Marek128b/HAM-Radio-transceiver-DA/filters/20m BP Filter/README.md

# 20m (14MHz - 14.35MHz) BP Filter 

** table of content **
- [20m (14MHz - 14.35MHz) BP Filter](#20m-14mhz---1435mhz-bp-filter)
  - [Description](#description)
  - [Circuit](#circuit)
  - [How it looks like in Real life](#how-it-looks-like-in-real-life)

## Description 
Bandpass filters are used to effectively reduce strong signals outside the operating band. This reduces noise and in-band noise, in a receiver there is a much lower risk of producing unwanted signals in the mixer. This gives better overall reception. <br>
On the transmit side, spurious emission signals are suppressed as well, reducing interference with the neighbouring stations. 

[comment]: <https://www.wimo.com/en/12410-20> (copied text from here)

## Circuit
The Circuit was designed with the online 
[Filter Tool](https://markimicrowave.com/technical-resources/tools/lc-filter-design-tool/)
to have a lower Frequency of 13MHz and a rather high upper cutoff frequency of 17MHz. 
The Air coils where calculated using the [Coil 32 online Tool](https://coil32.net/online-calculators/one-layer-coil-calculator.html). The coils where wound by hand using Wrapping wire around a 3D-Printed plastic core with respected diameters and lengths. <br>
The 3D-designs are found in the `20m BP Filter/hardware` folder.

<br>
20m 3rd Order Chebyshev Filter 

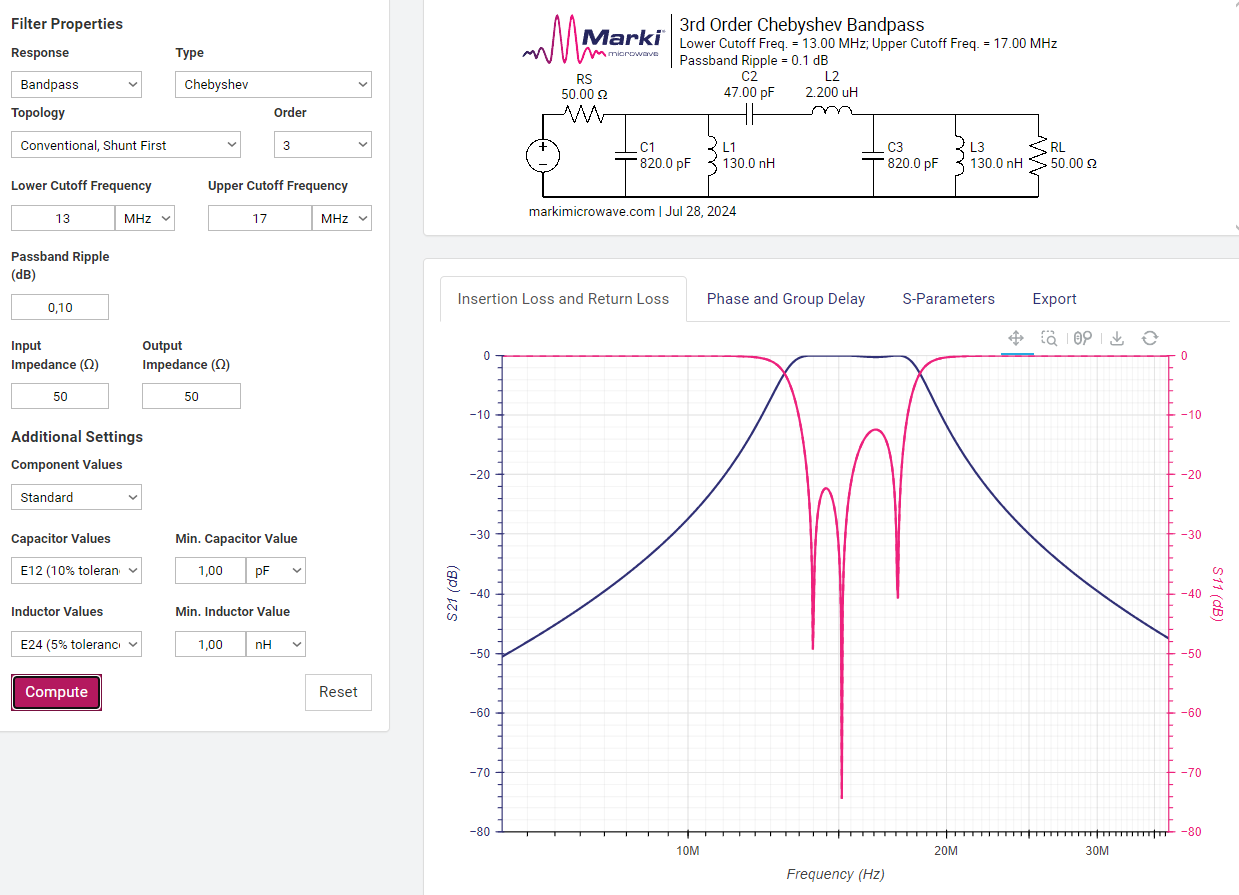
[picture p2: filters/20m BP Filter/img/Marki Filter 20m BO.PNG]


<br>
Simulated using LT-Spice with theoretical practical values:



<br>
Measured with the NanoVNA:

config in NanoVNA Saver v0.6.4:



S21 graph:



markers:



## How it looks like in Real life
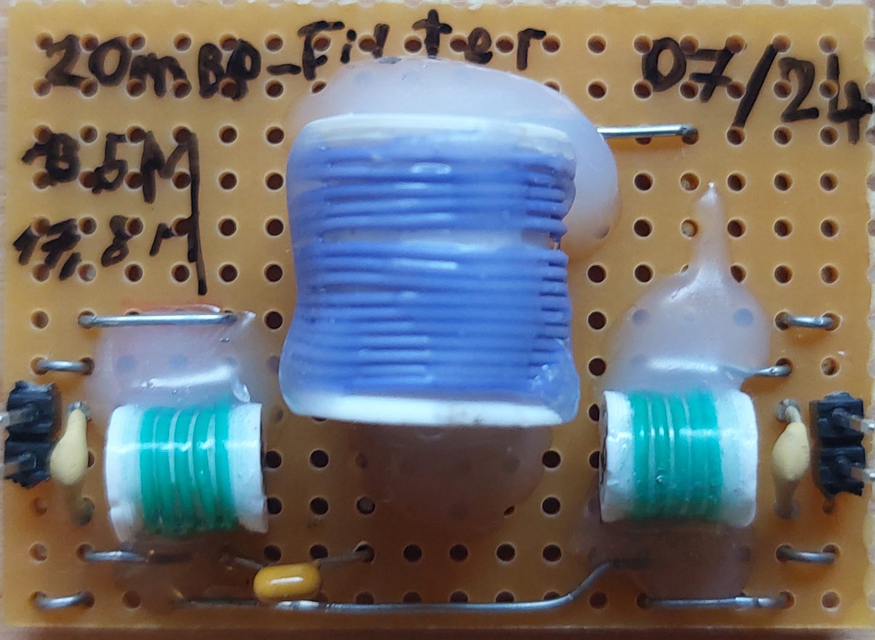
[picture p3: filters/20m BP Filter/img/WhatsApp Image 2024-07-28 at 16.52.38.jpeg]
