Marek128b/HAM-Radio-transceiver-DA/webpage/DocPage/content/1.Overview/_index.md

+++
archetype = "chapter"
title = "Overview"
weight = 1
+++

In this chapter you will find a quick overview about this documentation page and the ham radio project.

```mermaid {zoom="false"}
pie title Money for the project
  "Si5351" : 7
  "3.5 inch TFT LCD Module" : 17
  "ESP32-S3-DevKitC-1 Board" : 14
  "Hammond case 1455U1602BK" : 38
```
