Marek128b/HAM-Radio-transceiver-DA/webpage/DocPage/content/6.Schematics/_index.md

+++
archetype = "chapter"
title = "Schematics"
weight = 6
+++

This is a new chapter.
