Marek128b/HAM-Radio-transceiver-DA/webpage/DocPage/content/2.Filters/_index.md

+++
archetype = "chapter"
title = "Filters"
weight = 2
+++

This is a new chapter.
