Marek128b/HAM-Radio-transceiver-DA/webpage/DocPage/content/4.Power_Amplifier/_index.md

+++
archetype = "chapter"
title = "Power_Amplifier"
weight = 4
+++

This is a new chapter.
