Marek128b/HAM-Radio-transceiver-DA/webpage/DocPage/content/_index.md

### Image of the FunkY

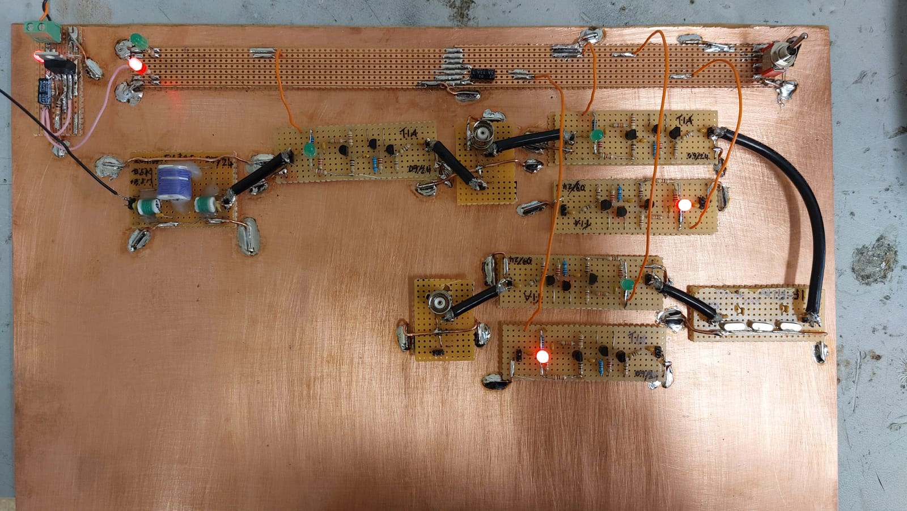
[picture p13: webpage/DocPage/content/WhatsApp Image 2024-10-16 at 08.23.57.jpeg]
something went wrong


### What this is about
This Project is an analog amateur radio for the 20m (14MHz) band. The aim of this project is to get beginners and non beginners into building their own amateur radio stations. This project webpage is a detailed documentation on how every component works and how to measure them and put the ham radio transceiver together.
