Marek128b/HAM-Radio-transceiver-DA/doc/concept presentation start.pptx

## Amateur funk Sender und Empfänger

- Georg Marek

## Idee:

- Ein Amateurfunk sende und Empfangs Einrichtung
- 10m bis 160m
- LSB, USB, CW

Georg Marek

## Blockschaltbild:

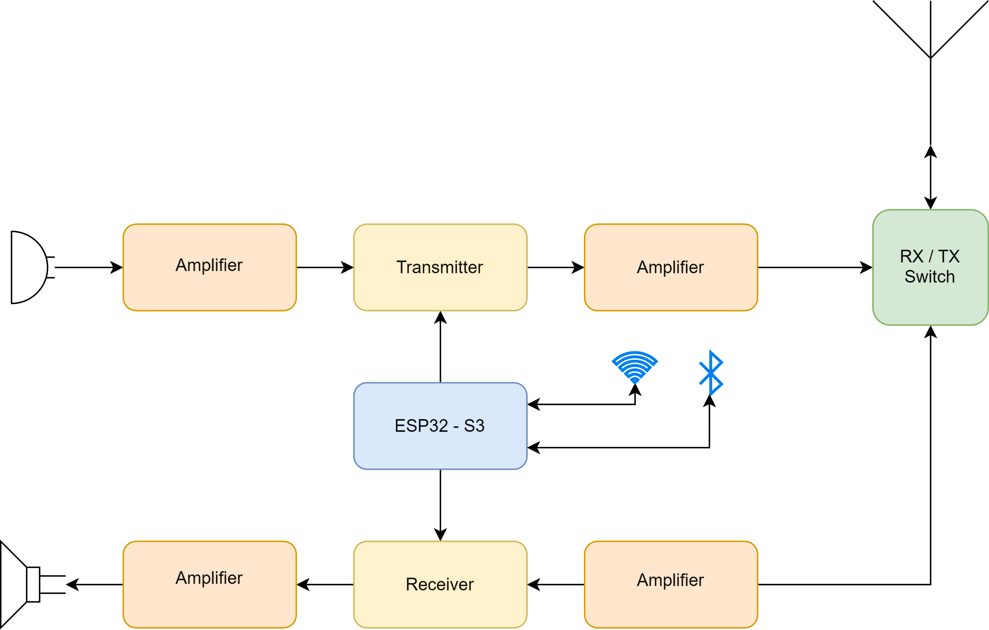
[picture p14: figure]

## Arbeitsaufteilung:

Georg Marek:
Sendeelektronik
Empfangselektronik
Mikrokontroller Programmierung
Schnittstellen Programmierung

Georg Marek:
Computer Software
Schnittstellen Programmierung

4

Georg Marek
