Marek128b/HAM-Radio-transceiver-DA/doc/case/img/case v34.png

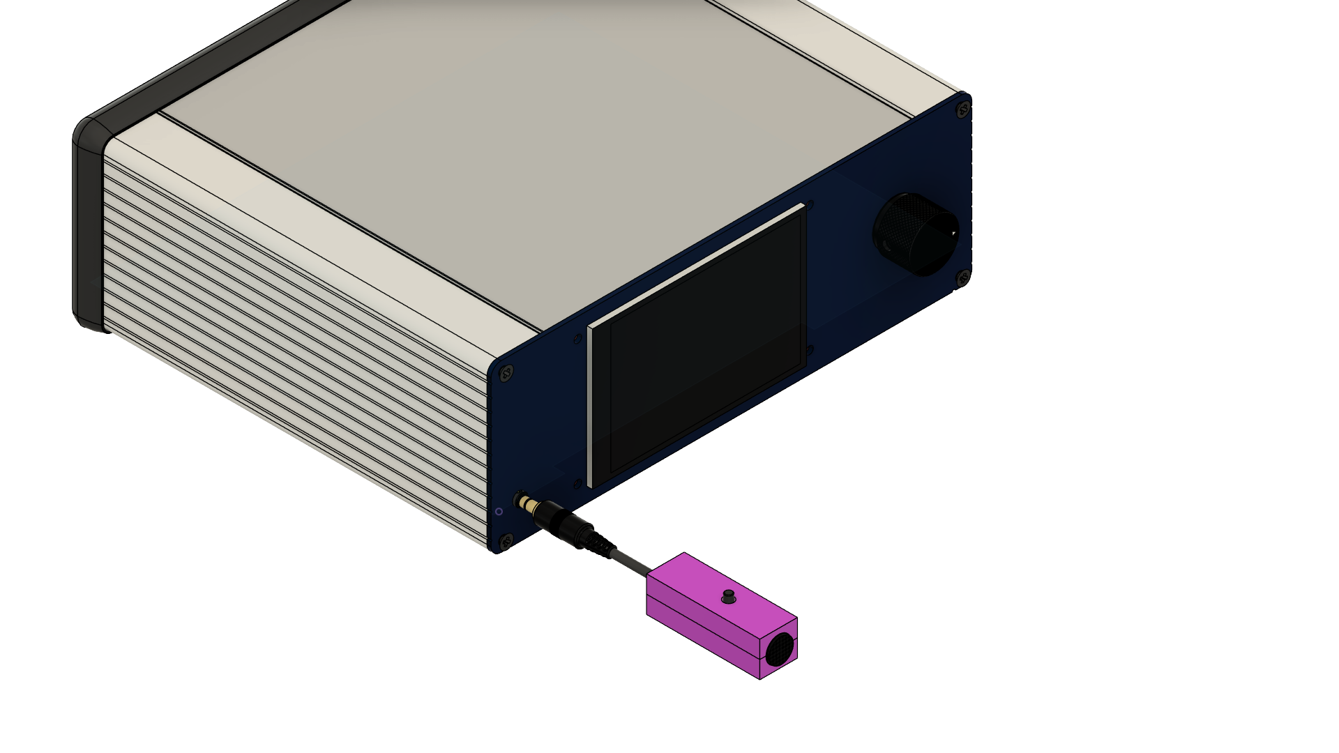
doc/case/img/case v34.png
