Marek128b/HAM-Radio-transceiver-DA/doc/case/img/case v43.png

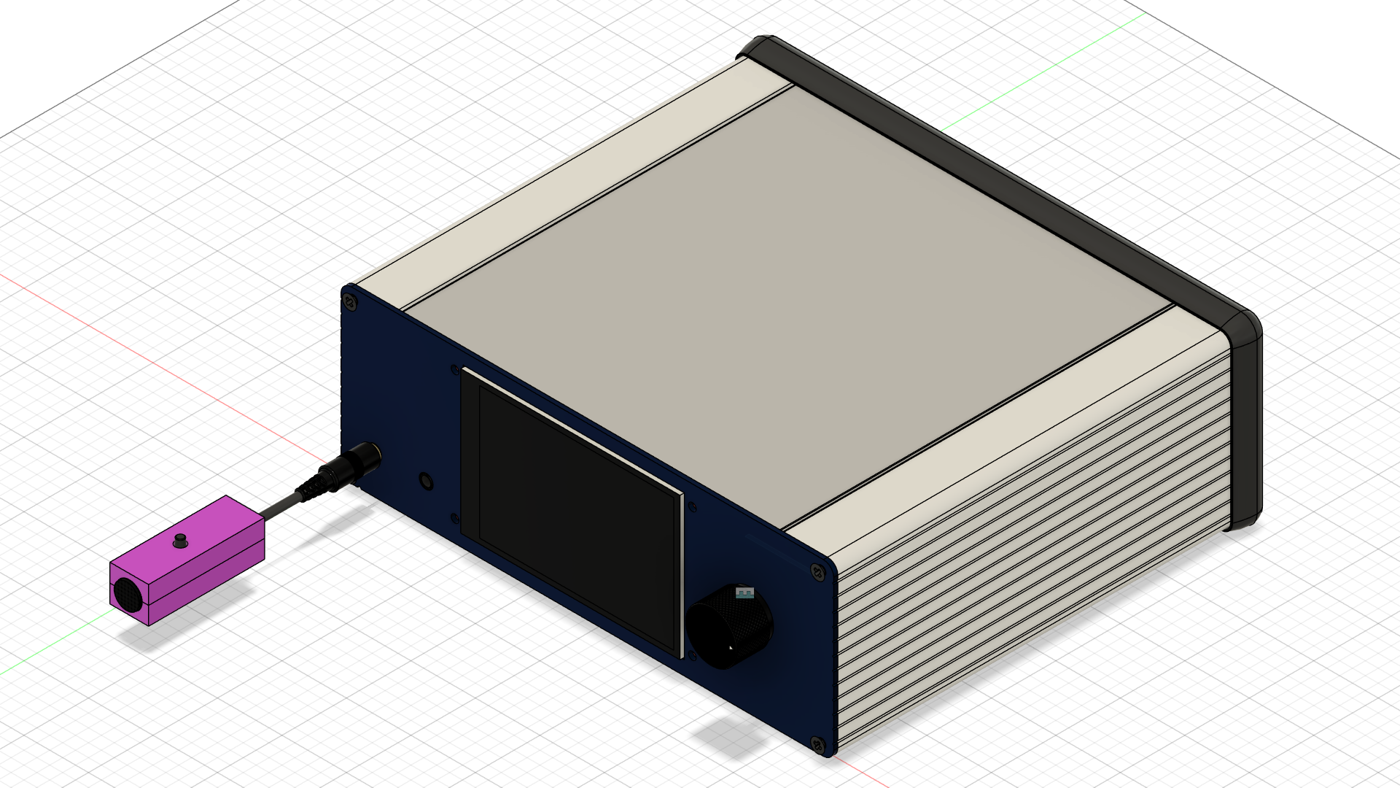
doc/case/img/case v43.png
