Marek128b/HAM-Radio-transceiver-DA/doc/img/blockdiagram.png

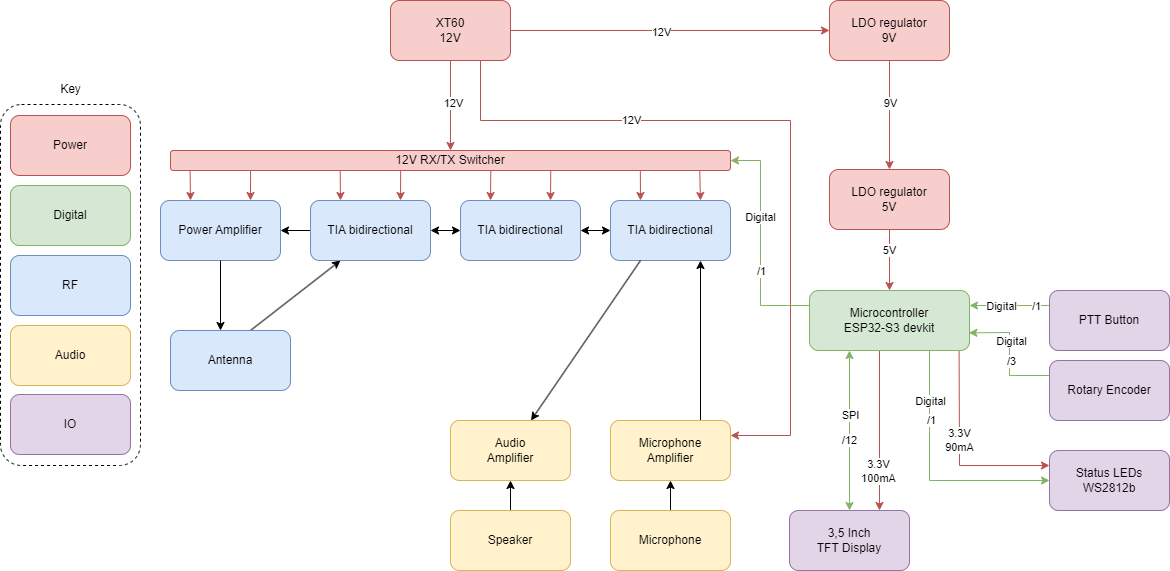
doc/img/blockdiagram.png
