Marek128b/HAM-Radio-transceiver-DA/doc/img/grundlagen-superhet-bfo.jpg

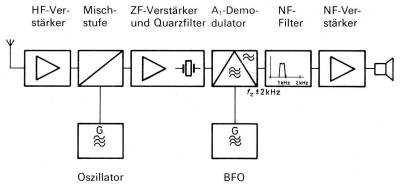
doc/img/grundlagen-superhet-bfo.jpg
