Marek128b/HAM-Radio-transceiver-DA/doc/img/grundlagen-superhet-ssb.jpg

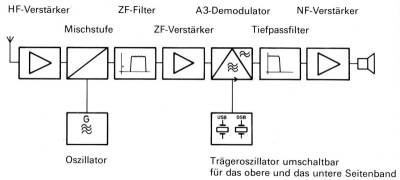
doc/img/grundlagen-superhet-ssb.jpg
