Marek128b/HAM-Radio-transceiver-DA/doc/img/Projectstructure.png

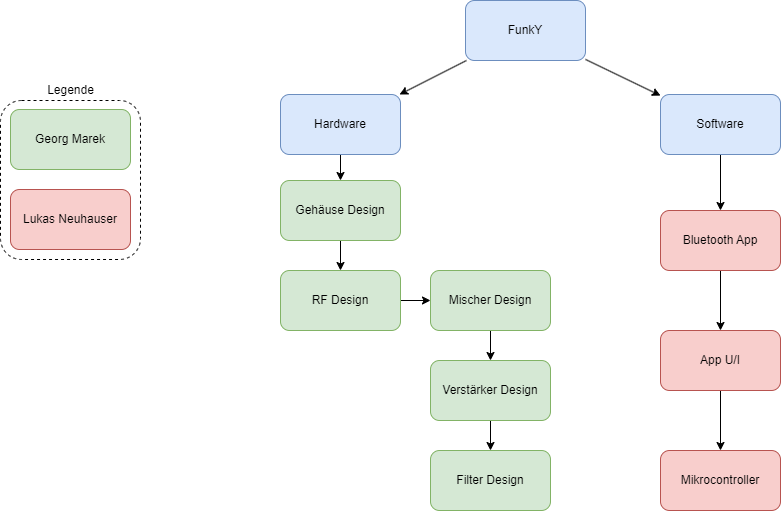
doc/img/Projectstructure.png
