Marek128b/HAM-Radio-transceiver-DA/doc/img/projectstructureplan.png

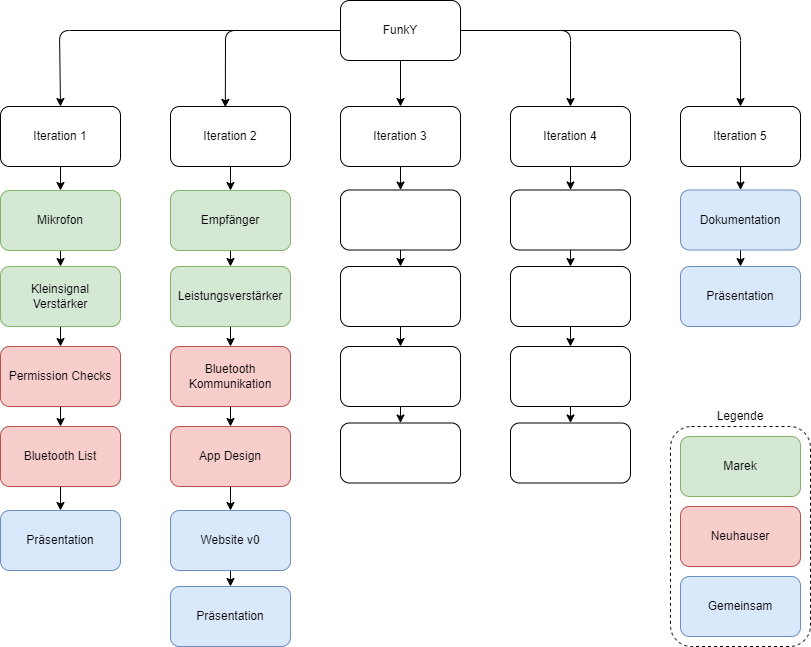
doc/img/projectstructureplan.png
