Marek128b/HAM-Radio-transceiver-DA/doc/img/recbasic2.gif

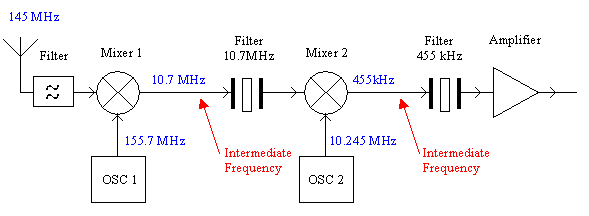
doc/img/recbasic2.gif
