Marek128b/HAM-Radio-transceiver-DA/doc/img/recbasic3.gif

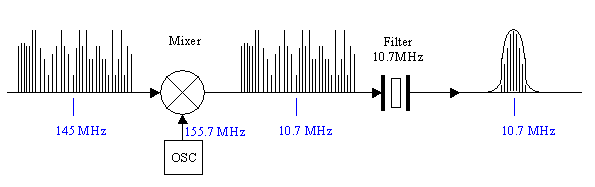
doc/img/recbasic3.gif
