Marek128b/HAM-Radio-transceiver-DA/doc/img/systemstructure.png

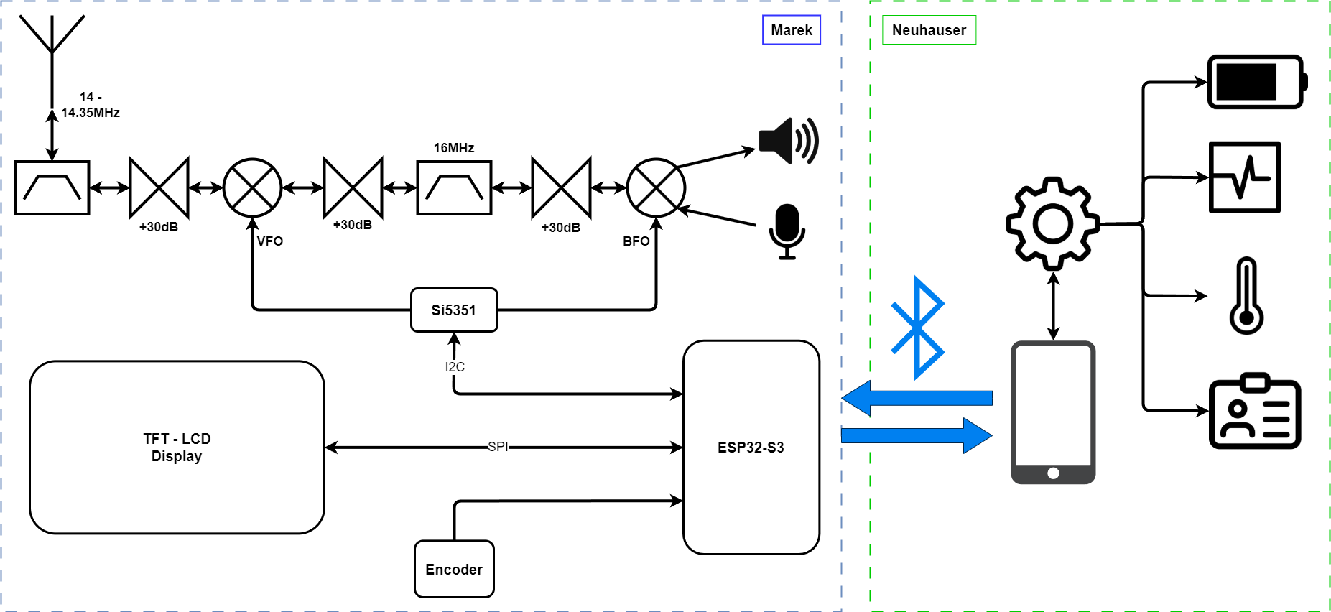
doc/img/systemstructure.png
