Marek128b/HAM-Radio-transceiver-DA/doc/img/USB-LSB.jpg

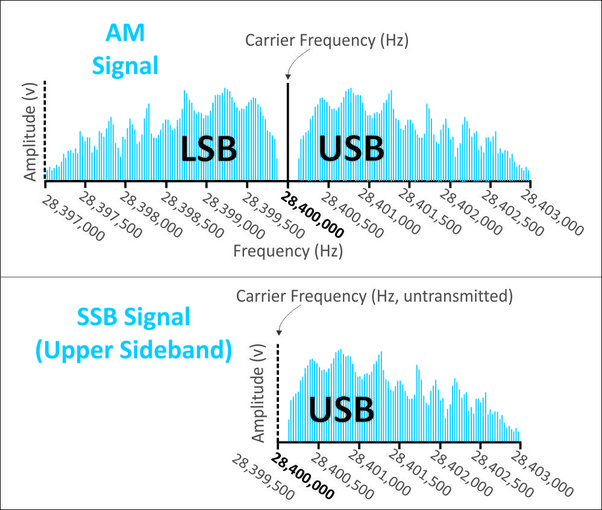
doc/img/USB-LSB.jpg
