Marek128b/HAM-Radio-transceiver-DA/doc/schematics-and-layouts/fritzing circuit Diagram.png

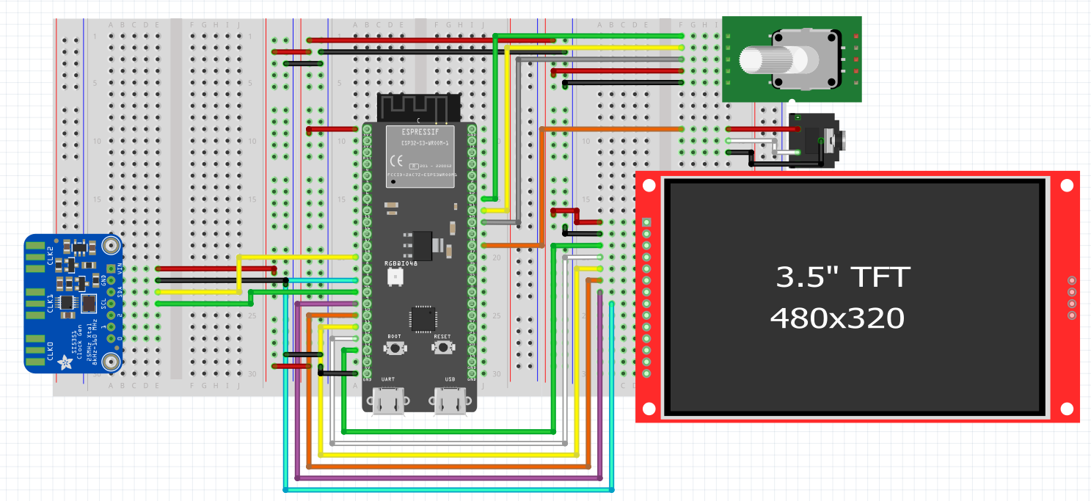
doc/schematics-and-layouts/fritzing circuit Diagram.png
