Marek128b/HAM-Radio-transceiver-DA/filters/20m BP Filter/img/WhatsApp Image 2024-07-26 at 18.50.19.jpeg

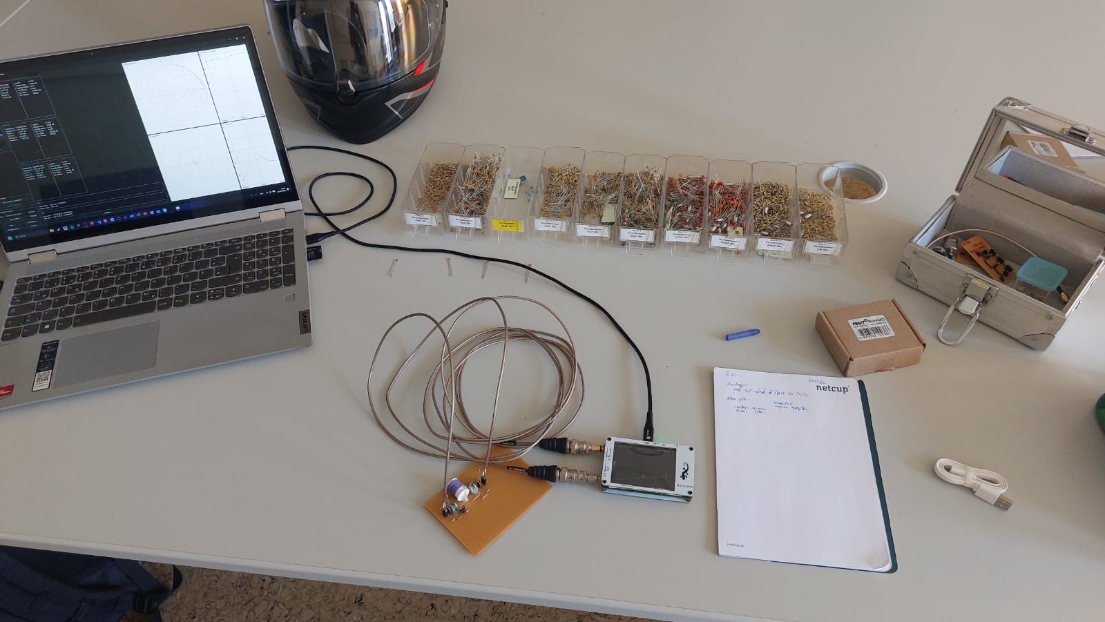
filters/20m BP Filter/img/WhatsApp Image 2024-07-26 at 18.50.19.jpeg
