Marek128b/HAM-Radio-transceiver-DA/filters/IF-Filter/img/WhatsApp Image 2024-07-18 at 14.03.02.jpeg

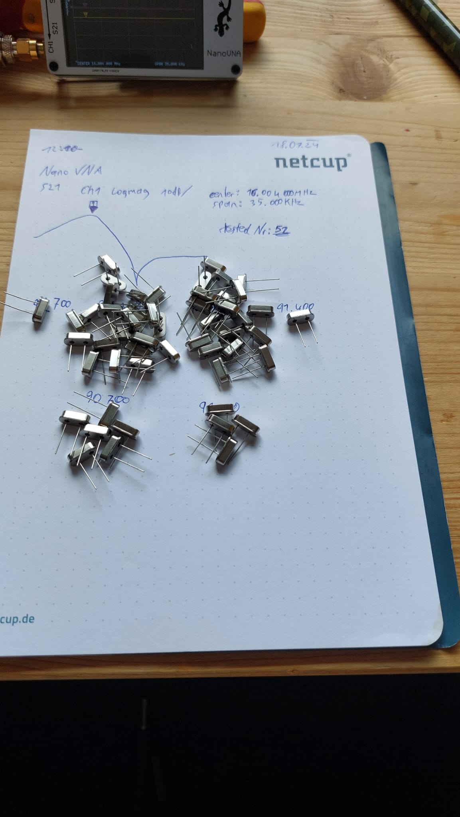
filters/IF-Filter/img/WhatsApp Image 2024-07-18 at 14.03.02.jpeg
