Marek128b/HAM-Radio-transceiver-DA/filters/IF-Filter/img/WhatsApp Image 2024-07-19 at 13.43.13 (1).jpeg

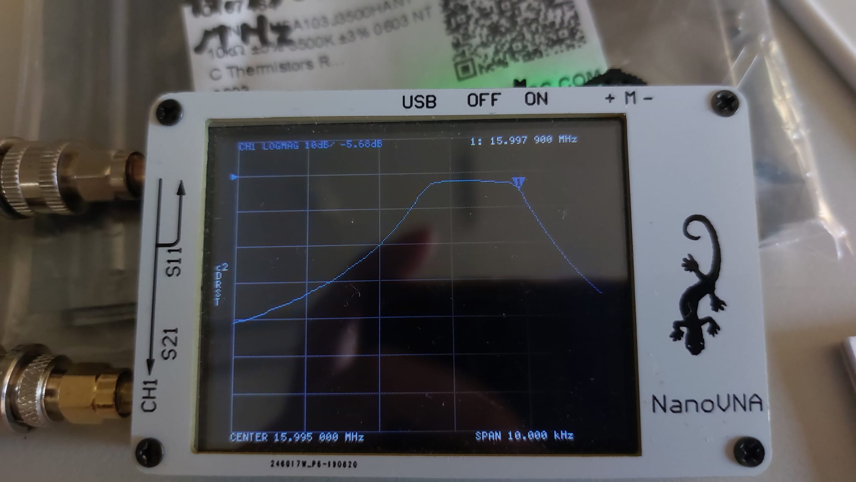
filters/IF-Filter/img/WhatsApp Image 2024-07-19 at 13.43.13 (1).jpeg
