Marek128b/HAM-Radio-transceiver-DA/doc/case/models/Front plate.3mf

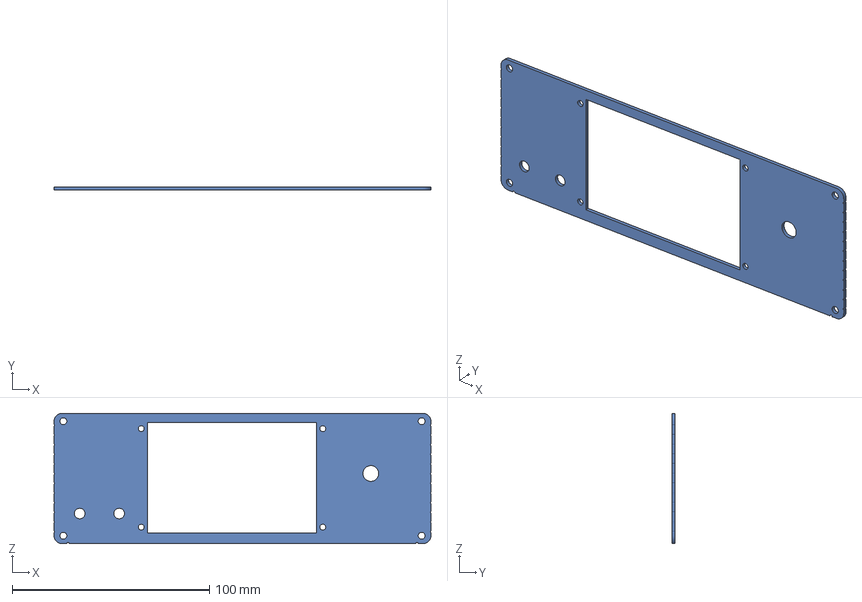
[picture p50: CAD file, 2025-04-04]
doc/case/models/Front plate.3mf
191.0 x 1.60 x 66.0 mm
