Marek128b/HAM-Radio-transceiver-DA/filters/20m BP Filter/hardware/Air Coil 12x11mm.3mf

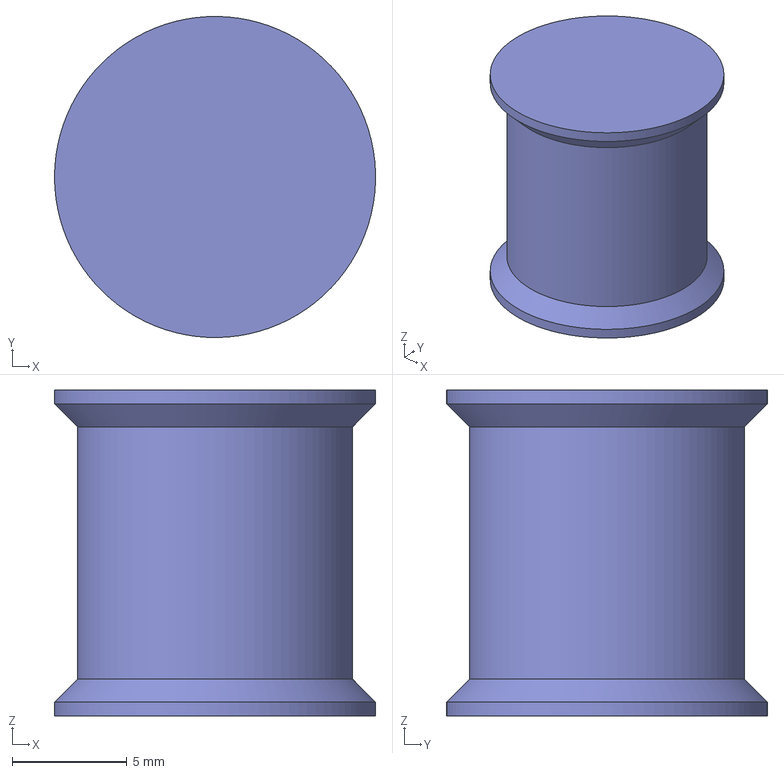
[picture p51: CAD file, 2024-07-28]
filters/20m BP Filter/hardware/Air Coil 12x11mm.3mf
14.0 x 14.0 x 14.2 mm
