Marek128b/HAM-Radio-transceiver-DA/filters/20m BP Filter/hardware/Air Coil 5x4mm.3mf

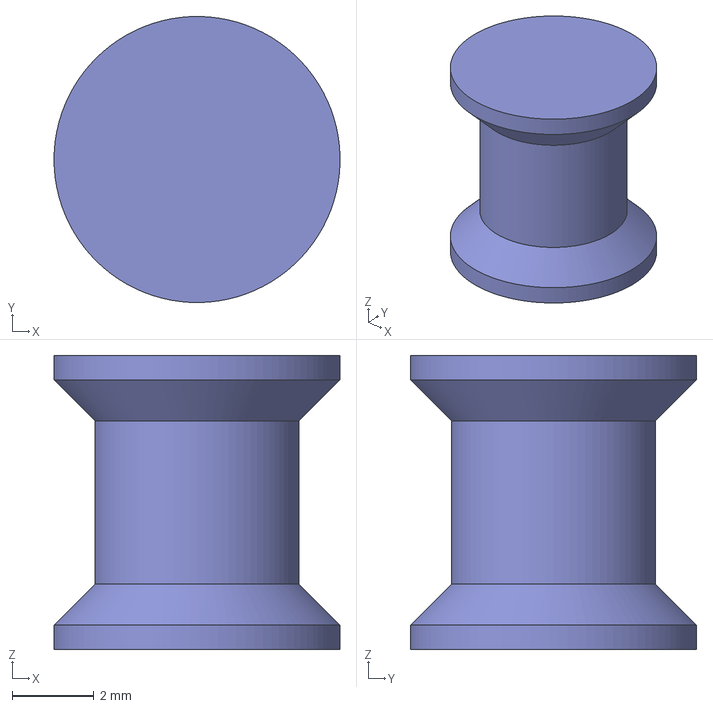
[picture p52: CAD file, 2024-07-28]
filters/20m BP Filter/hardware/Air Coil 5x4mm.3mf
7.00 x 7.00 x 7.20 mm
