Marek128b/HAM-Radio-transceiver-DA/(list of files, cad)

Other CAD files:
doc/case/models/Front plate v0.1 .3mf
