Marek128b/HAM-Radio-transceiver-DA/Amplifiers/TIA/Measurements/Cutoff analysis.png

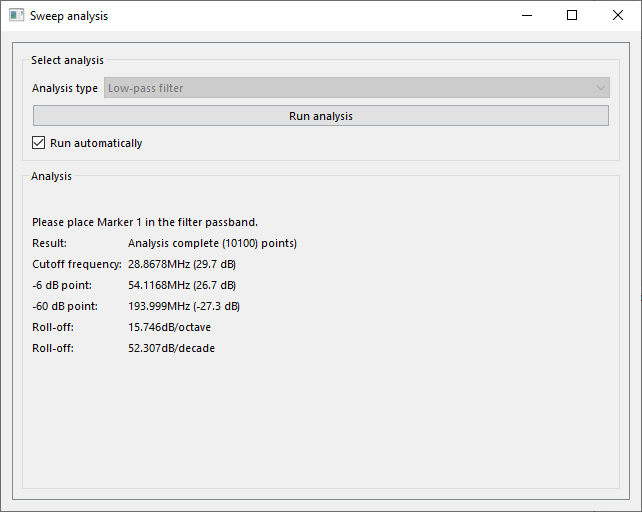
Amplifiers/TIA/Measurements/Cutoff analysis.png
