Marek128b/HAM-Radio-transceiver-DA/Amplifiers/TIA/Measurements/Gain TIA.png

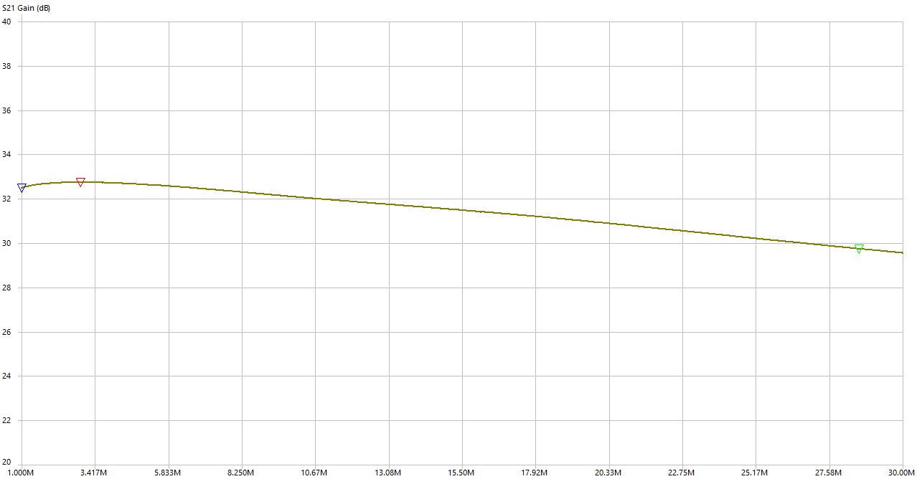
Amplifiers/TIA/Measurements/Gain TIA.png
