Marek128b/HAM-Radio-transceiver-DA/Amplifiers/TIA/Measurements/Smith TIA.png

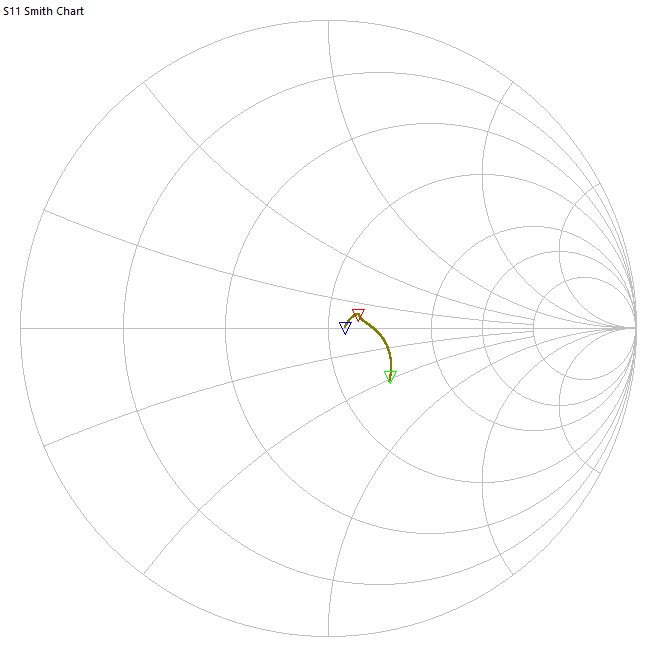
Amplifiers/TIA/Measurements/Smith TIA.png
