Marek128b/HAM-Radio-transceiver-DA/(threads)

Thread 2 (2024-05-22):

input image rejection filter for 20m band

Marek128b, 2024-05-22:

Marek128b, 2024-07-19:
### try nr. 1

tested 8 turns for 0.28uH
tested 24 turns for 2.8uH

C1/C3 = 470pF
C2 = 47pF

ins. Loss = 22.3dB
F_low = 4.19MHz
F_max = 9.70MHz

BW = 5.51MHz

Marek128b, 2024-07-19:
config in # 3

Marek128b, 2024-07-22:
using new design from qrp labs. [File](https://www.qrp-labs.com/images/bpfkit/bpf3.pdf)

Marek128b, 2024-07-22:
may only use one toroid and else aircoils.

[Filter Tool](https://markimicrowave.com/technical-resources/tools/lc-filter-design-tool/)

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

[Air Coil Tool](https://coil32.net/online-calculators/one-layer-coil-calculator.html
)

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

Marek128b, 2024-07-23:
### Wrapping wire

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

Marek128b, 2024-07-23:
### calculated whindings

#### 82nH
note: 5mm Diameter

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

#### 4.7uH
note: 12mm Diameter

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

Marek128b, 2024-07-24:
### Ideal Simulation of 20m BP Filter

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

Marek128b, 2024-07-24:
### Big 2.2uH
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

### small 130nH
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

### Simulation
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

Marek128b, 2024-07-26:
### limited components

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

used 1nF instead of 820pF

Marek128b, 2024-07-26:
### real world test with nano VNA

software: NanoVNA Saver v0.6.4

settings:
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

S21 trough:
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

Markers:
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

marker 1 and 2:
-6,5dB to -14dB = delta 7,5dB

---

Soldering header for switchable capacitors:

Marek128b, 2024-07-26:
### tested countless values

C1/C3 = 1nF
C2 = 22pF

L1/L3 = 5turn * 5mm
L2 = 15turn * 12mm

---

### results

S21 curve:
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

markers:
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

VNA Settings on NanoVNA saver v0.6.4:
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

Marek128b, 2024-07-27:
### 40m Filter idea

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

Marek128b, 2024-07-28:
### tested with 47pF and fixed design

config in NanoVNA Saver v0.6.4:
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

markers:
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

S21 graph:
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

Closed 2024-07-28.

Thread 12 (2024-06-28):

create IF crystal filter for SSB 2kHz-3kHz BW

Marek128b, 2024-06-28:

Marek128b, 2024-07-11:
## First test board for variable components:

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

## with drawn traces

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

---
Measured crystals for +- 100Hz <br>
Frequency is 3.999400Hz <br>
Capacitors used: 100pF

Marek128b, 2024-07-16:
4MHz OK for CW bw: 700Hz with 15pF <br>
next trying 16MHz for SSB with 220pF

Marek128b, 2024-07-18:
### test stand for crystals
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

### fine frequency selection
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

### test with 16MHz crystals and 150pF capacitors
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

Marek128b, 2024-07-18:
next: try out 100pF and lower values to get higher bandwidth.

Closed 2024-07-19.

Thread 19 (2024-07-25):

simulating and building test circuit for TIA (termination insensitive amplifier)

Marek128b, 2024-07-25:

Marek128b, 2024-07-31:
### PCB design first test

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

Marek128b, 2024-07-31:
### Strip board layout

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

Marek128b, 2024-08-01:
### design on strip board (not soldered)
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

Marek128b, 2024-08-02:
### all 6 TIAs soldered
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

Marek128b, 2024-08-03:
### update broken TIAs
tested current draw:
expected: 30mA per stage
1x 34mA
5x 92mA !!!!

next: test problems with almost all TIAs

Marek128b, 2024-08-03:
### posible problems
1. 2N3904 from china all dead.
2. R1 / the 1KOhm resistor not soldered correctly. needs to go from transistor collector to +12V.

Marek128b, 2024-08-03:
### Simulation schematics

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

Marek128b, 2024-08-04:
### fixing problems
1. fixed solder joint between base of Q1 and emitter of Q2 (wrong connection, had to cut)
2. fixed solder joint between base of Q2 and collector/+12V of Q3 (wrong connection, had to cut)

Marek128b, 2024-08-04:
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

Marek128b, 2024-08-04:
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
[PCB_NEW_PCB_2024-08-04 (1).pdf](https://github.com/user-attachments/files/16486996/PCB_NEW_PCB_2024-08-04.1.pdf)

Marek128b, 2024-08-11:
### Amplification problem

Marek128b, 2024-08-15:
### found something
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

Marek128b, 2024-08-15:
### measurements
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
Blue is input, yellow is output
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

Marek128b, 2024-09-13:
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
Note: this is tested using the Nanovna with the homebrew  **30dB Attenuator**

Marek128b, 2024-09-13:
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
[PCB_NEW_PCB_2024-09-13.pdf](https://github.com/user-attachments/files/16997751/PCB_NEW_PCB_2024-09-13.pdf)

Marek128b, 2024-09-14:
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

Marek128b, 2024-09-14:
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

Closed 2024-09-30.

Thread 24 (2024-08-02):

test ADE1+ mixers and calculate LO/VFO and BFO for receiver part

Marek128b, 2024-08-02:

Marek128b, 2024-09-18:
### Calculations

FIN: 14MHz - 14.35MHz
IF(SSB): 15,995.200 MHz
VFO: Fselect + IF
BFO: IF - IFbw

---
**bsp: 14,25MHz**
VFO: 14.25MHz + 15,995.200MHz = 30,245.200MHz
BFO: 15,994.930MHz

Marek128b, 2024-09-23:
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

Marek128b, 2024-09-23:
### Carrier Suppression
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
https://youtu.be/KBq0sblnHWs?si=N27_1A014SqPFMJd

Marek128b, 2024-09-23:
### Biasing circuit
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

Marek128b, 2024-09-24:
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

Closed 2024-09-30.

Thread 28 (2024-09-15):

Test first receive with laboratory equipment

Marek128b, 2024-09-15:

Marek128b, 2024-10-14:
### building the transceiver on the ground plate
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

Marek128b, 2024-10-21:
### Settings for IC7200
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

Marek128b, 2024-10-21:
https://www.icomeurope.com/files/IC-7200_IM_D_20140912.pdf

Marek128b, 2024-10-21:
### status
Receiving a signal SSB. Getting converted to IF. After filter no signal.

Marek128b, 2024-10-22:
### todo
1. test output frequency of SI5351.
2. maybe remove bnc of mainboard.

Marek128b, 2024-10-22:
trouble shooting guide
https://www.worldradiohistory.com/BOOKSHELF-ARH/Technology/Rider-Books/Rider-Radio-Troubleshooting-Guidebook-Rider-Johnson.pdf

Marek128b, 2024-10-22:
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

Marek128b, 2024-10-22:
### tested SI5351
needs output filter;
NOTE: BFO wrong frequency, should be **15.997900MHz**

Marek128b, 2024-10-22:
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
SI5351 Frequencies not correct.
Next re calibrate Si5351.

Marek128b, 2024-10-22:
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

Marek128b, 2024-10-22:
### Problem with Si5351
1. Frequency stability.

done:
1. re calibrated si5351 (value: 155989)
2. written test code (si5351 calibrated test)

### Fixes
1. don't set the frequency all the time in the loop and only when it changes.

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

Marek128b, 2024-10-22:
### Working Version (Firmware v0.0.3)

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

Closed 2024-11-13.

Thread 30 (2024-09-20):

simulating Power Amplifier

Marek128b, 2024-09-20:

Marek128b, 2024-09-21:
[Amplifier class B](https://www.youtube.com/watch?v=eu54pe0LhpM&list=PLT84nve2j1g_UO_7hj0HPrVwNj3NGQeES&index=3)

Marek128b, 2024-09-27:
### Simulation of ZL2CTM PA
https://zl2ctm.blogspot.com/2020/11/go-qrp-portable-ssb-rig.html

### Simulation in LTspicer
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

### Output Signal Power
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
Average Power: 5.11W

### Output Signal Voltage
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

### Output Signal Current
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

### Output Signal FFT
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

NEED to add output filtering.

Marek128b, 2024-09-27:
### Ferrite FT 37-43
https://www.reichelt.at/at/de/shop/produkt/ferritring_5943000201-7929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
€ 0,95

Marek128b, 2024-10-17:
### Finding better Amplifier with less harmonics

Marek128b, 2024-10-24:
### found
https://youtu.be/Rje5DJSe098?si=3Z9jGiuyOqo_luwW
https://youtu.be/E1LEE0wEAy8?si=7rnbQVkuhlr2koRD
https://www.qsl.net/on6mu/schemas/RF_amplifier_15and17_meterband_10w_HFamp.htm

Marek128b, 2024-11-03:
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

Marek128b, 2024-11-03:
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

Marek128b, 2024-11-08:
with new Transistor and input matching network.
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
Matched input signal:
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
Output power;
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
Output spektrum:
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

Closed 2024-11-09.

Thread 34 (2024-09-30):

create Schematics for Filters

Marek128b, 2024-09-30:

Marek128b, 2024-10-17:
[Schematic_SSB-transceiver-multi-band_2024-10-17 (1).pdf](https://github.com/user-attachments/files/17413499/Schematic_SSB-transceiver-multi-band_2024-10-17.1.pdf)
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

Closed 2024-10-21.

Thread 38 (2024-10-09):

building and testing PA

Marek128b, 2024-10-09:

Marek128b, 2024-10-25:
### Possible Transistors
1. https://www.lcsc.com/product-detail/Bipolar-BJT_UTC-Unisonic-Tech-2SD1804L-T-TN3-R_C85224.html
2. https://www.lcsc.com/product-detail/Bipolar-BJT_SPS-2SC4552T2TL_C462395.html
3. https://www.lcsc.com/product-detail/Bipolar-BJT_ROHM-Semicon-2SCR586D3TL1_C2842346.html

Marek128b, 2024-10-25:
### Amplifier Types
AB: https://www.electronics-tutorials.ws/amplifier/class-ab-amplifier.html

Marek128b, 2024-10-26:
### Simulation
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

Power dissipated on R4 is 10W

Marek128b, 2025-03-25:
### Simulation new
with new Transistor and input matching network.
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
Matched input signal:
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
Output power;
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
Output spektrum:
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

Marek128b, 2025-03-26:
### Found Turn Ratio Pair

| Name| Value|
|--------|--------|
| Source impedance | 14.4 Ohm|
| Load impedance | 50 Ohm|
| Min. Frequency | 3 MHz |

Using T37-6 or T60-26

| Pri turns | Sec turns|
|--------|--------|
| 15| 28|

Marek128b, 2025-03-26:
### Efficiency

Class-A amplifiers are inefficient. A maximum theoretical efficiency of 25% is obtainable using usual configurations, but 50% is the maximum for a transformer or inductively coupled configuration.

https://en.wikipedia.org/wiki/Power_amplifier_classes#:~:text=Class-A%20amplifiers%20are%20inefficient,transformer%20or%20inductively%20coupled%20configuration.

Thread 52 (2024-11-04):

test transmit ssb

Marek128b, 2024-11-04:

Marek128b, 2024-11-04:
### Test Nr.1
SDR on output of TIA_Nr.5 TX.2 after SSB Filter
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

Marek128b, 2024-11-05:
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
carrier suppression not working

Marek128b, 2024-11-06:
NEXT: create Double balanced diode ring Mixer with carrier suppression

Closed 2024-11-13.

Thread 56 (2024-11-11):

create Double balanced diode ring Mixer

Marek128b, 2024-11-11:
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

Marek128b, 2024-11-11:
https://www.youtube.com/watch?v=7CA_lkLYqMM

Marek128b, 2024-11-12:
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

Marek128b, 2024-11-12:
1. Matching the Diodes (1N4001)
2. Winding the Trifilar transformers with 10 Turns on FT37-6
3. removing the isolation of the copper wires using a lighter
4. remove carbon layer from wires
5. testing continuity to find coil pairs
6. testing Potentiometer
7. creating the diode ring
8. soldering Potentiometer in place
9. solder LO (VFO/BFO) Trifilar transformer
10. add BNC to LO  (VFO/BFO)
11. create center tap to IF/RF transformer
13. solder IF/RF Trifilar transformer
14. solder Inputs for IF and RF port

Marek128b, 2024-11-12:
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

Closed 2024-11-13.

Thread 64 (2024-12-01):

fixing mixers

Marek128b, 2024-12-01:

Marek128b, 2024-12-03:
Fix with Diplexer acording to:
1. https://www.youtube.com/watch?v=O4TM6pSiY0M
2. https://www.youtube.com/watch?v=IPf8Z2ElSos

Calculator:
https://www.changpuak.ch/electronics/calc_16a.php

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

Marek128b, 2024-12-03:
### Simulation
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

Marek128b, 2024-12-03:
### Trimmable coils
https://www.coilcraft.com/de-de/products/rf/tunable-rf-inductors/vertical-mount/uni5/
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

Marek128b, 2024-12-08:
### hardware
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

Marek128b, 2024-12-09:
### Data
| Type | Data|
|--------|--------|
| insertion Loss: | 12.63dB => 4,26 times less|
| Input Impedance: | 49.3Ohm |

Marek128b, 2025-02-27:
### Building Toriod
T60-26 with 18 Turns Trifilar

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

Thread 66 (2025-01-07):

testing xtals on PCB

Marek128b, 2025-01-07:

Marek128b, 2025-01-07:
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

Marek128b, 2025-01-07:
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

Marek128b, 2025-01-07:
[XTALs.xlsx](https://github.com/user-attachments/files/18329619/XTALs.xlsx)

Marek128b, 2025-01-07:
using XTAL 15.99443x MHz

Marek128b, 2025-01-07:
Ins Loss | 3db BW | Min | Max | BW
-- | -- | -- | -- | --
-3,8 | -6,8 | 15995100 | 15996550 | 1450
  | 6db BW |   |   |  
  | -9,8 | 15994950 | 15996700 | 1750
  | 20dB BW |   |   |  

Marek128b, 2025-01-11:
### 4. Test mit Normal + 33pF = 133pF
Aim BW is 2.5kHz
Ins Loss | 3db BW | Min | Max | BW
-- | -- | -- | -- | --
-3,5 | -6,5 | 15995150 | 15997350 | 2200
  | 6db BW |   |   |  
  | -9,5 | 15995000 | 15997500 | 2500
  | 20dB BW |   |   |  
| | -23,5 | 15994300 | 15998050 | 3750

Marek128b, 2025-01-11:
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

Closed 2025-01-11.

Thread 70 (2025-01-13):

building Input Filter for 20m

Marek128b, 2025-01-13:

Marek128b, 2025-02-10:
### First Test Simulation

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

Marek128b, 2025-02-10:
### Calculate Coils

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

Marek128b, 2025-02-24:
### Test 1

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

Marek128b, 2025-02-24:
### Test 3

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

Marek128b, 2025-02-24:
### Test 4

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

Marek128b, 2025-02-25:
### Test 5

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

22p, 3.3nF, 3Turn

Marek128b, 2025-02-25:
### Test 6

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

22pF, 2.2nF, 3Turn

Marek128b, 2025-02-25:
### Test 7

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

22pF, 1.5nF, 3Turn

Marek128b, 2025-02-25:
### Test 9

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

22pF, 1.5nF || 330pF || 220pF, 3Turn

Marek128b, 2025-02-25:
### Test 10

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

15pF, 1.5nF || 330pF || 220pF, 3Turn

Marek128b, 2025-02-25:
Test 10

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

15pF, 1.5nF || 330pF , 3Turn

Marek128b, 2025-02-25:
Test 11

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

15pF, 1.5nF , 3Turn

Marek128b, 2025-02-25:
Test 12

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

33pF, 1.5nF, 3Turn

Marek128b, 2025-02-25:
Test 13

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

33pF, 1.5nF || 330pF , 3Turn

Marek128b, 2025-02-25:
Test 15

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

33pF, 1.5nF || 330pF || 220pF || 100pF, 3Turn

Closed 2025-02-25.

Thread 81 (2025-01-20):

fixing RXTX voltage

Marek128b, 2025-01-20:

Marek128b, 2025-01-21:
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

Marek128b, 2025-02-09:
### Fixed

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

Thread 87 (2025-02-04):

fixing power issue

Marek128b, 2025-02-04:

Marek128b, 2025-02-04:
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

Marek128b, 2025-02-04:
### Cause of problem

Short on uC that draws less than 2A total.
AMS1117 IC cant handle more than 1A => fuse didn't blow, both regulators dead

Closed 2025-02-04.

Thread 88 (2025-02-04):

tessting Temperature Sensor

Marek128b, 2025-02-04:

Marek128b, 2025-02-04:
/**
* Die NTC Tabelle, bestehend aus 4096 Temperaturstützpunkten.
* Einheit:1 °C
*
*/
int NTC_table[4096] = {
  1310, 1036, 762, 650, 583, 538, 505, 478,
  457, 439, 424, 411, 399, 388, 379, 371, 363,
  356, 349, 343, 338, 332, 327, 323, 318, 314,
  310, 307, 303, 300, 296, 293, 290, 287, 285,
  282, 279, 277, 275, 272, 270, 268, 266, 264,
  262, 260, 258, 257, 255, 253, 251, 250, 248,
  247, 245, 244, 242, 241, 240, 238, 237, 236,
  235, 233, 232, 231, 230, 229, 228, 227, 225,
  224, 223, 222, 221, 220, 219, 219, 218, 217,
  216, 215, 214, 213, 212, 212, 211, 210, 209,
  208, 208, 207, 206, 205, 205, 204, 203, 202,
  202, 201, 200, 200, 199, 198, 198, 197, 197,
  196, 195, 195, 194, 194, 193, 192, 192, 191,
  191, 190, 190, 189, 189, 188, 187, 187, 186,
  186, 185, 185, 184, 184, 183, 183, 182, 182,
  182, 181, 181, 180, 180, 179, 179, 178, 178,
  178, 177, 177, 176, 176, 175, 175, 175, 174,
  174, 173, 173, 173, 172, 172, 171, 171, 171,
  170, 170, 170, 169, 169, 169, 168, 168, 167,
  167, 167, 166, 166, 166, 165, 165, 165, 164,
  164, 164, 163, 163, 163, 163, 162, 162, 162,
  161, 161, 161, 160, 160, 160, 159, 159, 159,
  159, 158, 158, 158, 157, 157, 157, 157, 156,
  156, 156, 156, 155, 155, 155, 154, 154, 154,
  154, 153, 153, 153, 153, 152, 152, 152, 152,
  151, 151, 151, 151, 150, 150, 150, 150, 149,
  149, 149, 149, 148, 148, 148, 148, 148, 147,
  147, 147, 147, 146, 146, 146, 146, 146, 145,
  145, 145, 145, 144, 144, 144, 144, 144, 143,
  143, 143, 143, 143, 142, 142, 142, 142, 142,
  141, 141, 141, 141, 141, 140, 140, 140, 140,
  140, 139, 139, 139, 139, 139, 139, 138, 138,
  138, 138, 138, 137, 137, 137, 137, 137, 137,
  136, 136, 136, 136, 136, 135, 135, 135, 135,
  135, 135, 134, 134, 134, 134, 134, 134, 133,
  133, 133, 133, 133, 133, 132, 132, 132, 132,
  132, 132, 131, 131, 131, 131, 131, 131, 131,
  130, 130, 130, 130, 130, 130, 129, 129, 129,
  129, 129, 129, 129, 128, 128, 128, 128, 128,
  128, 127, 127, 127, 127, 127, 127, 127, 126,
  126, 126, 126, 126, 126, 126, 125, 125, 125,
  125, 125, 125, 125, 125, 124, 124, 124, 124,
  124, 124, 124, 123, 123, 123, 123, 123, 123,
  123, 123, 122, 122, 122, 122, 122, 122, 122,
  122, 121, 121, 121, 121, 121, 121, 121, 121,
  120, 120, 120, 120, 120, 120, 120, 120, 119,
  119, 119, 119, 119, 119, 119, 119, 118, 118,
  118, 118, 118, 118, 118, 118, 118, 117, 117,
  117, 117, 117, 117, 117, 117, 116, 116, 116,
  116, 116, 116, 116, 116, 116, 115, 115, 115,
  115, 115, 115, 115, 115, 115, 114, 114, 114,
  114, 114, 114, 114, 114, 114, 114, 113, 113,
  113, 113, 113, 113, 113, 113, 113, 112, 112,
  112, 112, 112, 112, 112, 112, 112, 112, 111,
  111, 111, 111, 111, 111, 111, 111, 111, 111,
  110, 110, 110, 110, 110, 110, 110, 110, 110,
  110, 109, 109, 109, 109, 109, 109, 109, 109,
  109, 109, 109, 108, 108, 108, 108, 108, 108,
  108, 108, 108, 108, 108, 107, 107, 107, 107,
  107, 107, 107, 107, 107, 107, 106, 106, 106,
  106, 106, 106, 106, 106, 106, 106, 106, 106,
  105, 105, 105, 105, 105, 105, 105, 105, 105,
  105, 105, 104, 104, 104, 104, 104, 104, 104,
  104, 104, 104, 104, 104, 103, 103, 103, 103,
  103, 103, 103, 103, 103, 103, 103, 103, 102,
  102, 102, 102, 102, 102, 102, 102, 102, 102,
  102, 102, 101, 101, 101, 101, 101, 101, 101,
  101, 101, 101, 101, 101, 101, 100, 100, 100,
  100, 100, 100, 100, 100, 100, 100, 100, 100,
  100, 99, 99, 99, 99, 99, 99, 99, 99, 99,
  99, 99, 99, 99, 98, 98, 98, 98, 98, 98, 98,
  98, 98, 98, 98, 98, 98, 97, 97, 97, 97, 97,
  97, 97, 97, 97, 97, 97, 97, 97, 97, 96, 96,
  96, 96, 96, 96, 96, 96, 96, 96, 96, 96, 96,
  96, 95, 95, 95, 95, 95, 95, 95, 95, 95, 95,
  95, 95, 95, 95, 95, 94, 94, 94, 94, 94, 94,
  94, 94, 94, 94, 94, 94, 94, 94, 93, 93, 93,
  93, 93, 93, 93, 93, 93, 93, 93, 93, 93, 93,
  93, 92, 92, 92, 92, 92, 92, 92, 92, 92, 92,
  92, 92, 92, 92, 92, 92, 91, 91, 91, 91, 91,
  91, 91, 91, 91, 91, 91, 91, 91, 91, 91, 91,
  90, 90, 90, 90, 90, 90, 90, 90, 90, 90, 90,
  90, 90, 90, 90, 90, 89, 89, 89, 89, 89, 89,
  89, 89, 89, 89, 89, 89, 89, 89, 89, 89, 88,
  88, 88, 88, 88, 88, 88, 88, 88, 88, 88, 88,
  88, 88, 88, 88, 88, 87, 87, 87, 87, 87, 87,
  87, 87, 87, 87, 87, 87, 87, 87, 87, 87, 87,
  86, 86, 86, 86, 86, 86, 86, 86, 86, 86, 86,
  86, 86, 86, 86, 86, 86, 86, 85, 85, 85, 85,
  85, 85, 85, 85, 85, 85, 85, 85, 85, 85, 85,
  85, 85, 85, 84, 84, 84, 84, 84, 84, 84, 84,
  84, 84, 84, 84, 84, 84, 84, 84, 84, 84, 83,
  83, 83, 83, 83, 83, 83, 83, 83, 83, 83, 83,
  83, 83, 83, 83, 83, 83, 83, 82, 82, 82, 82,
  82, 82, 82, 82, 82, 82, 82, 82, 82, 82, 82,
  82, 82, 82, 82, 81, 81, 81, 81, 81, 81, 81,
  81, 81, 81, 81, 81, 81, 81, 81, 81, 81, 81,
  81, 80, 80, 80, 80, 80, 80, 80, 80, 80, 80,
  80, 80, 80, 80, 80, 80, 80, 80, 80, 80, 79,
  79, 79, 79, 79, 79, 79, 79, 79, 79, 79, 79,
  79, 79, 79, 79, 79, 79, 79, 79, 78, 78, 78,
  78, 78, 78, 78, 78, 78, 78, 78, 78, 78, 78,
  78, 78, 78, 78, 78, 78, 78, 77, 77, 77, 77,
  77, 77, 77, 77, 77, 77, 77, 77, 77, 77, 77,
  77, 77, 77, 77, 77, 77, 76, 76, 76, 76, 76,
  76, 76, 76, 76, 76, 76, 76, 76, 76, 76, 76,
  76, 76, 76, 76, 76, 76, 75, 75, 75, 75, 75,
  75, 75, 75, 75, 75, 75, 75, 75, 75, 75, 75,
  75, 75, 75, 75, 75, 75, 74, 74, 74, 74, 74,
  74, 74, 74, 74, 74, 74, 74, 74, 74, 74, 74,
  74, 74, 74, 74, 74, 74, 73, 73, 73, 73, 73,
  73, 73, 73, 73, 73, 73, 73, 73, 73, 73, 73,
  73, 73, 73, 73, 73, 73, 73, 72, 72, 72, 72,
  72, 72, 72, 72, 72, 72, 72, 72, 72, 72, 72,
  72, 72, 72, 72, 72, 72, 72, 72, 72, 71, 71,
  71, 71, 71, 71, 71, 71, 71, 71, 71, 71, 71,
  71, 71, 71, 71, 71, 71, 71, 71, 71, 71, 70,
  70, 70, 70, 70, 70, 70, 70, 70, 70, 70, 70,
  70, 70, 70, 70, 70, 70, 70, 70, 70, 70, 70,
  70, 70, 69, 69, 69, 69, 69, 69, 69, 69, 69,
  69, 69, 69, 69, 69, 69, 69, 69, 69, 69, 69,
  69, 69, 69, 69, 68, 68, 68, 68, 68, 68, 68,
  68, 68, 68, 68, 68, 68, 68, 68, 68, 68, 68,
  68, 68, 68, 68, 68, 68, 68, 67, 67, 67, 67,
  67, 67, 67, 67, 67, 67, 67, 67, 67, 67, 67,
  67, 67, 67, 67, 67, 67, 67, 67, 67, 67, 67,
  66, 66, 66, 66, 66, 66, 66, 66, 66, 66, 66,
  66, 66, 66, 66, 66, 66, 66, 66, 66, 66, 66,
  66, 66, 66, 66, 65, 65, 65, 65, 65, 65, 65,
  65, 65, 65, 65, 65, 65, 65, 65, 65, 65, 65,
  65, 65, 65, 65, 65, 65, 65, 65, 65, 64, 64,
  64, 64, 64, 64, 64, 64, 64, 64, 64, 64, 64,
  64, 64, 64, 64, 64, 64, 64, 64, 64, 64, 64,
  64, 64, 64, 63, 63, 63, 63, 63, 63, 63, 63,
  63, 63, 63, 63, 63, 63, 63, 63, 63, 63, 63,
  63, 63, 63, 63, 63, 63, 63, 63, 62, 62, 62,
  62, 62, 62, 62, 62, 62, 62, 62, 62, 62, 62,
  62, 62, 62, 62, 62, 62, 62, 62, 62, 62, 62,
  62, 62, 62, 61, 61, 61, 61, 61, 61, 61, 61,
  61, 61, 61, 61, 61, 61, 61, 61, 61, 61, 61,
  61, 61, 61, 61, 61, 61, 61, 61, 61, 60, 60,
  60, 60, 60, 60, 60, 60, 60, 60, 60, 60, 60,
  60, 60, 60, 60, 60, 60, 60, 60, 60, 60, 60,
  60, 60, 60, 60, 60, 59, 59, 59, 59, 59, 59,
  59, 59, 59, 59, 59, 59, 59, 59, 59, 59, 59,
  59, 59, 59, 59, 59, 59, 59, 59, 59, 59, 59,
  59, 58, 58, 58, 58, 58, 58, 58, 58, 58, 58,
  58, 58, 58, 58, 58, 58, 58, 58, 58, 58, 58,
  58, 58, 58, 58, 58, 58, 58, 58, 58, 57, 57,
  57, 57, 57, 57, 57, 57, 57, 57, 57, 57, 57,
  57, 57, 57, 57, 57, 57, 57, 57, 57, 57, 57,
  57, 57, 57, 57, 57, 57, 56, 56, 56, 56, 56,
  56, 56, 56, 56, 56, 56, 56, 56, 56, 56, 56,
  56, 56, 56, 56, 56, 56, 56, 56, 56, 56, 56,
  56, 56, 56, 55, 55, 55, 55, 55, 55, 55, 55,
  55, 55, 55, 55, 55, 55, 55, 55, 55, 55, 55,
  55, 55, 55, 55, 55, 55, 55, 55, 55, 55, 55,
  55, 54, 54, 54, 54, 54, 54, 54, 54, 54, 54,
  54, 54, 54, 54, 54, 54, 54, 54, 54, 54, 54,
  54, 54, 54, 54, 54, 54, 54, 54, 54, 54, 53,
  53, 53, 53, 53, 53, 53, 53, 53, 53, 53, 53,
  53, 53, 53, 53, 53, 53, 53, 53, 53, 53, 53,
  53, 53, 53, 53, 53, 53, 53, 53, 53, 52, 52,
  52, 52, 52, 52, 52, 52, 52, 52, 52, 52, 52,
  52, 52, 52, 52, 52, 52, 52, 52, 52, 52, 52,
  52, 52, 52, 52, 52, 52, 52, 52, 51, 51, 51,
  51, 51, 51, 51, 51, 51, 51, 51, 51, 51, 51,
  51, 51, 51, 51, 51, 51, 51, 51, 51, 51, 51,
  51, 51, 51, 51, 51, 51, 51, 51, 50, 50, 50,
  50, 50, 50, 50, 50, 50, 50, 50, 50, 50, 50,
  50, 50, 50, 50, 50, 50, 50, 50, 50, 50, 50,
  50, 50, 50, 50, 50, 50, 50, 50, 49, 49, 49,
  49, 49, 49, 49, 49, 49, 49, 49, 49, 49, 49,
  49, 49, 49, 49, 49, 49, 49, 49, 49, 49, 49,
  49, 49, 49, 49, 49, 49, 49, 49, 48, 48, 48,
  48, 48, 48, 48, 48, 48, 48, 48, 48, 48, 48,
  48, 48, 48, 48, 48, 48, 48, 48, 48, 48, 48,
  48, 48, 48, 48, 48, 48, 48, 48, 47, 47, 47,
  47, 47, 47, 47, 47, 47, 47, 47, 47, 47, 47,
  47, 47, 47, 47, 47, 47, 47, 47, 47, 47, 47,
  47, 47, 47, 47, 47, 47, 47, 47, 47, 46, 46,
  46, 46, 46, 46, 46, 46, 46, 46, 46, 46, 46,
  46, 46, 46, 46, 46, 46, 46, 46, 46, 46, 46,
  46, 46, 46, 46, 46, 46, 46, 46, 46, 46, 46,
  45, 45, 45, 45, 45, 45, 45, 45, 45, 45, 45,
  45, 45, 45, 45, 45, 45, 45, 45, 45, 45, 45,
  45, 45, 45, 45, 45, 45, 45, 45, 45, 45, 45,
  45, 44, 44, 44, 44, 44, 44, 44, 44, 44, 44,
  44, 44, 44, 44, 44, 44, 44, 44, 44, 44, 44,
  44, 44, 44, 44, 44, 44, 44, 44, 44, 44, 44,
  44, 44, 44, 43, 43, 43, 43, 43, 43, 43, 43,
  43, 43, 43, 43, 43, 43, 43, 43, 43, 43, 43,
  43, 43, 43, 43, 43, 43, 43, 43, 43, 43, 43,
  43, 43, 43, 43, 43, 42, 42, 42, 42, 42, 42,
  42, 42, 42, 42, 42, 42, 42, 42, 42, 42, 42,
  42, 42, 42, 42, 42, 42, 42, 42, 42, 42, 42,
  42, 42, 42, 42, 42, 42, 42, 42, 41, 41, 41,
  41, 41, 41, 41, 41, 41, 41, 41, 41, 41, 41,
  41, 41, 41, 41, 41, 41, 41, 41, 41, 41, 41,
  41, 41, 41, 41, 41, 41, 41, 41, 41, 41, 40,
  40, 40, 40, 40, 40, 40, 40, 40, 40, 40, 40,
  40, 40, 40, 40, 40, 40, 40, 40, 40, 40, 40,
  40, 40, 40, 40, 40, 40, 40, 40, 40, 40, 40,
  40, 40, 39, 39, 39, 39, 39, 39, 39, 39, 39,
  39, 39, 39, 39, 39, 39, 39, 39, 39, 39, 39,
  39, 39, 39, 39, 39, 39, 39, 39, 39, 39, 39,
  39, 39, 39, 39, 39, 38, 38, 38, 38, 38, 38,
  38, 38, 38, 38, 38, 38, 38, 38, 38, 38, 38,
  38, 38, 38, 38, 38, 38, 38, 38, 38, 38, 38,
  38, 38, 38, 38, 38, 38, 38, 38, 37, 37, 37,
  37, 37, 37, 37, 37, 37, 37, 37, 37, 37, 37,
  37, 37, 37, 37, 37, 37, 37, 37, 37, 37, 37,
  37, 37, 37, 37, 37, 37, 37, 37, 37, 37, 37,
  37, 36, 36, 36, 36, 36, 36, 36, 36, 36, 36,
  36, 36, 36, 36, 36, 36, 36, 36, 36, 36, 36,
  36, 36, 36, 36, 36, 36, 36, 36, 36, 36, 36,
  36, 36, 36, 36, 35, 35, 35, 35, 35, 35, 35,
  35, 35, 35, 35, 35, 35, 35, 35, 35, 35, 35,
  35, 35, 35, 35, 35, 35, 35, 35, 35, 35, 35,
  35, 35, 35, 35, 35, 35, 35, 35, 34, 34, 34,
  34, 34, 34, 34, 34, 34, 34, 34, 34, 34, 34,
  34, 34, 34, 34, 34, 34, 34, 34, 34, 34, 34,
  34, 34, 34, 34, 34, 34, 34, 34, 34, 34, 34,
  34, 33, 33, 33, 33, 33, 33, 33, 33, 33, 33,
  33, 33, 33, 33, 33, 33, 33, 33, 33, 33, 33,
  33, 33, 33, 33, 33, 33, 33, 33, 33, 33, 33,
  33, 33, 33, 33, 33, 32, 32, 32, 32, 32, 32,
  32, 32, 32, 32, 32, 32, 32, 32, 32, 32, 32,
  32, 32, 32, 32, 32, 32, 32, 32, 32, 32, 32,
  32, 32, 32, 32, 32, 32, 32, 32, 31, 31, 31,
  31, 31, 31, 31, 31, 31, 31, 31, 31, 31, 31,
  31, 31, 31, 31, 31, 31, 31, 31, 31, 31, 31,
  31, 31, 31, 31, 31, 31, 31, 31, 31, 31, 31,
  31, 30, 30, 30, 30, 30, 30, 30, 30, 30, 30,
  30, 30, 30, 30, 30, 30, 30, 30, 30, 30, 30,
  30, 30, 30, 30, 30, 30, 30, 30, 30, 30, 30,
  30, 30, 30, 30, 30, 29, 29, 29, 29, 29, 29,
  29, 29, 29, 29, 29, 29, 29, 29, 29, 29, 29,
  29, 29, 29, 29, 29, 29, 29, 29, 29, 29, 29,
  29, 29, 29, 29, 29, 29, 29, 29, 29, 28, 28,
  28, 28, 28, 28, 28, 28, 28, 28, 28, 28, 28,
  28, 28, 28, 28, 28, 28, 28, 28, 28, 28, 28,
  28, 28, 28, 28, 28, 28, 28, 28, 28, 28, 28,
  28, 28, 27, 27, 27, 27, 27, 27, 27, 27, 27,
  27, 27, 27, 27, 27, 27, 27, 27, 27, 27, 27,
  27, 27, 27, 27, 27, 27, 27, 27, 27, 27, 27,
  27, 27, 27, 27, 27, 26, 26, 26, 26, 26, 26,
  26, 26, 26, 26, 26, 26, 26, 26, 26, 26, 26,
  26, 26, 26, 26, 26, 26, 26, 26, 26, 26, 26,
  26, 26, 26, 26, 26, 26, 26, 26, 26, 25, 25,
  25, 25, 25, 25, 25, 25, 25, 25, 25, 25, 25,
  25, 25, 25, 25, 25, 25, 25, 25, 25, 25, 25,
  25, 25, 25, 25, 25, 25, 25, 25, 25, 25, 25,
  25, 24, 24, 24, 24, 24, 24, 24, 24, 24, 24,
  24, 24, 24, 24, 24, 24, 24, 24, 24, 24, 24,
  24, 24, 24, 24, 24, 24, 24, 24, 24, 24, 24,
  24, 24, 24, 24, 24, 23, 23, 23, 23, 23, 23,
  23, 23, 23, 23, 23, 23, 23, 23, 23, 23, 23,
  23, 23, 23, 23, 23, 23, 23, 23, 23, 23, 23,
  23, 23, 23, 23, 23, 23, 23, 23, 22, 22, 22,
  22, 22, 22, 22, 22, 22, 22, 22, 22, 22, 22,
  22, 22, 22, 22, 22, 22, 22, 22, 22, 22, 22,
  22, 22, 22, 22, 22, 22, 22, 22, 22, 22, 21,
  21, 21, 21, 21, 21, 21, 21, 21, 21, 21, 21,
  21, 21, 21, 21, 21, 21, 21, 21, 21, 21, 21,
  21, 21, 21, 21, 21, 21, 21, 21, 21, 21, 21,
  21, 21, 20, 20, 20, 20, 20, 20, 20, 20, 20,
  20, 20, 20, 20, 20, 20, 20, 20, 20, 20, 20,
  20, 20, 20, 20, 20, 20, 20, 20, 20, 20, 20,
  20, 20, 20, 20, 19, 19, 19, 19, 19, 19, 19,
  19, 19, 19, 19, 19, 19, 19, 19, 19, 19, 19,
  19, 19, 19, 19, 19, 19, 19, 19, 19, 19, 19,
  19, 19, 19, 19, 19, 19, 18, 18, 18, 18, 18,
  18, 18, 18, 18, 18, 18, 18, 18, 18, 18, 18,
  18, 18, 18, 18, 18, 18, 18, 18, 18, 18, 18,
  18, 18, 18, 18, 18, 18, 18, 18, 17, 17, 17,
  17, 17, 17, 17, 17, 17, 17, 17, 17, 17, 17,
  17, 17, 17, 17, 17, 17, 17, 17, 17, 17, 17,
  17, 17, 17, 17, 17, 17, 17, 17, 17, 17, 16,
  16, 16, 16, 16, 16, 16, 16, 16, 16, 16, 16,
  16, 16, 16, 16, 16, 16, 16, 16, 16, 16, 16,
  16, 16, 16, 16, 16, 16, 16, 16, 16, 16, 16,
  15, 15, 15, 15, 15, 15, 15, 15, 15, 15, 15,
  15, 15, 15, 15, 15, 15, 15, 15, 15, 15, 15,
  15, 15, 15, 15, 15, 15, 15, 15, 15, 15, 15,
  14, 14, 14, 14, 14, 14, 14, 14, 14, 14, 14,
  14, 14, 14, 14, 14, 14, 14, 14, 14, 14, 14,
  14, 14, 14, 14, 14, 14, 14, 14, 14, 14, 14,
  13, 13, 13, 13, 13, 13, 13, 13, 13, 13, 13,
  13, 13, 13, 13, 13, 13, 13, 13, 13, 13, 13,
  13, 13, 13, 13, 13, 13, 13, 13, 13, 13, 13,
  12, 12, 12, 12, 12, 12, 12, 12, 12, 12, 12,
  12, 12, 12, 12, 12, 12, 12, 12, 12, 12, 12,
  12, 12, 12, 12, 12, 12, 12, 12, 12, 12, 12,
  11, 11, 11, 11, 11, 11, 11, 11, 11, 11, 11,
  11, 11, 11, 11, 11, 11, 11, 11, 11, 11, 11,
  11, 11, 11, 11, 11, 11, 11, 11, 11, 10, 10,
  10, 10, 10, 10, 10, 10, 10, 10, 10, 10, 10,
  10, 10, 10, 10, 10, 10, 10, 10, 10, 10, 10,
  10, 10, 10, 10, 10, 10, 10, 10, 9, 9, 9,
  9, 9, 9, 9, 9, 9, 9, 9, 9, 9, 9, 9, 9, 9,
  9, 9, 9, 9, 9, 9, 9, 9, 9, 9, 9, 9, 9, 9,
  8, 8, 8, 8, 8, 8, 8, 8, 8, 8, 8, 8, 8, 8,
  8, 8, 8, 8, 8, 8, 8, 8, 8, 8, 8, 8, 8, 8,
  8, 8, 7, 7, 7, 7, 7, 7, 7, 7, 7, 7, 7, 7,
  7, 7, 7, 7, 7, 7, 7, 7, 7, 7, 7, 7, 7, 7,
  7, 7, 7, 7, 6, 6, 6, 6, 6, 6, 6, 6, 6, 6,
  6, 6, 6, 6, 6, 6, 6, 6, 6, 6, 6, 6, 6, 6,
  6, 6, 6, 6, 6, 5, 5, 5, 5, 5, 5, 5, 5, 5,
  5, 5, 5, 5, 5, 5, 5, 5, 5, 5, 5, 5, 5, 5,
  5, 5, 5, 5, 5, 5, 4, 4, 4, 4, 4, 4, 4, 4,
  4, 4, 4, 4, 4, 4, 4, 4, 4, 4, 4, 4, 4, 4,
  4, 4, 4, 4, 4, 4, 3, 3, 3, 3, 3, 3, 3, 3,
  3, 3, 3, 3, 3, 3, 3, 3, 3, 3, 3, 3, 3, 3,
  3, 3, 3, 3, 3, 3, 2, 2, 2, 2, 2, 2, 2, 2,
  2, 2, 2, 2, 2, 2, 2, 2, 2, 2, 2, 2, 2, 2,
  2, 2, 2, 2, 2, 1, 1, 1, 1, 1, 1, 1, 1, 1,
  1, 1, 1, 1, 1, 1, 1, 1, 1, 1, 1, 1, 1, 1,
  1, 1, 1, 0, 0, 0, 0, 0, 0, 0, 0, 0, 0, 0,
  0, 0, 0, 0, 0, 0, 0, 0, 0, 0, 0, 0, 0, 0,
  0, -1, -1, -1, -1, -1, -1, -1, -1, -1, -1,
  -1, -1, -1, -1, -1, -1, -1, -1, -1, -1, -1,
  -1, -1, -1, -1, -2, -2, -2, -2, -2, -2, -2,
  -2, -2, -2, -2, -2, -2, -2, -2, -2, -2, -2,
  -2, -2, -2, -2, -2, -2, -3, -3, -3, -3, -3,
  -3, -3, -3, -3, -3, -3, -3, -3, -3, -3, -3,
  -3, -3, -3, -3, -3, -3, -3, -3, -4, -4, -4,
  -4, -4, -4, -4, -4, -4, -4, -4, -4, -4, -4,
  -4, -4, -4, -4, -4, -4, -4, -4, -4, -4, -5,
  -5, -5, -5, -5, -5, -5, -5, -5, -5, -5, -5,
  -5, -5, -5, -5, -5, -5, -5, -5, -5, -5, -6,
  -6, -6, -6, -6, -6, -6, -6, -6, -6, -6, -6,
  -6, -6, -6, -6, -6, -6, -6, -6, -6, -6, -7,
  -7, -7, -7, -7, -7, -7, -7, -7, -7, -7, -7,
  -7, -7, -7, -7, -7, -7, -7, -7, -7, -7, -8,
  -8, -8, -8, -8, -8, -8, -8, -8, -8, -8, -8,
  -8, -8, -8, -8, -8, -8, -8, -8, -9, -9, -9,
  -9, -9, -9, -9, -9, -9, -9, -9, -9, -9, -9,
  -9, -9, -9, -9, -9, -9, -9, -10, -10, -10,
  -10, -10, -10, -10, -10, -10, -10, -10, -10,
  -10, -10, -10, -10, -10, -10, -10, -11, -11,
  -11, -11, -11, -11, -11, -11, -11, -11, -11,
  -11, -11, -11, -11, -11, -11, -11, -11, -12,
  -12, -12, -12, -12, -12, -12, -12, -12, -12,
  -12, -12, -12, -12, -12, -12, -12, -12, -13,
  -13, -13, -13, -13, -13, -13, -13, -13, -13,
  -13, -13, -13, -13, -13, -13, -13, -13, -14,
  -14, -14, -14, -14, -14, -14, -14, -14, -14,
  -14, -14, -14, -14, -14, -14, -14, -15, -15,
  -15, -15, -15, -15, -15, -15, -15, -15, -15,
  -15, -15, -15, -15, -15, -15, -16, -16, -16,
  -16, -16, -16, -16, -16, -16, -16, -16, -16,
  -16, -16, -16, -16, -17, -17, -17, -17, -17,
  -17, -17, -17, -17, -17, -17, -17, -17, -17,
  -17, -18, -18, -18, -18, -18, -18, -18, -18,
  -18, -18, -18, -18, -18, -18, -18, -19, -19,
  -19, -19, -19, -19, -19, -19, -19, -19, -19,
  -19, -19, -19, -19, -20, -20, -20, -20, -20,
  -20, -20, -20, -20, -20, -20, -20, -20, -21,
  -21, -21, -21, -21, -21, -21, -21, -21, -21,
  -21, -21, -21, -21, -22, -22, -22, -22, -22,
  -22, -22, -22, -22, -22, -22, -22, -23, -23,
  -23, -23, -23, -23, -23, -23, -23, -23, -23,
  -23, -23, -24, -24, -24, -24, -24, -24, -24,
  -24, -24, -24, -24, -25, -25, -25, -25, -25,
  -25, -25, -25, -25, -25, -25, -25, -26, -26,
  -26, -26, -26, -26, -26, -26, -26, -26, -26,
  -27, -27, -27, -27, -27, -27, -27, -27, -27,
  -27, -28, -28, -28, -28, -28, -28, -28, -28,
  -28, -28, -29, -29, -29, -29, -29, -29, -29,
  -29, -29, -30, -30, -30, -30, -30, -30, -30,
  -30, -30, -31, -31, -31, -31, -31, -31, -31,
  -31, -31, -32, -32, -32, -32, -32, -32, -32,
  -32, -33, -33, -33, -33, -33, -33, -33, -33,
  -34, -34, -34, -34, -34, -34, -34, -34, -35,
  -35, -35, -35, -35, -35, -35, -36, -36, -36,
  -36, -36, -36, -36, -37, -37, -37, -37, -37,
  -37, -38, -38, -38, -38, -38, -38, -39, -39,
  -39, -39, -39, -39, -40, -40, -40, -40, -40,
  -40, -41, -41, -41, -41, -41, -42, -42, -42,
  -42, -42, -43, -43, -43, -43, -43, -44, -44,
  -44, -44, -44, -45, -45, -45, -45, -46, -46,
  -46, -46, -47, -47, -47, -47, -48, -48, -48,
  -49, -49, -49, -49, -50, -50, -50, -51, -51,
  -51, -52, -52, -52, -53, -53, -54, -54, -54,
  -55, -55, -56, -56, -56, -57, -57, -58, -58,
  -59, -59, -60, -61, -61, -62, -63, -63, -64,
  -65, -66, -66, -67, -68, -69, -71, -72, -73,
  -75, -76, -79, -81, -84, -88, -92
};

/**
* \brief    Konvertiert das ADC Ergebnis in einen Temperaturwert.
*
*           Die Temperaturwerte werden direkt aus der Tabelle gelesen.
*
* \param    adc_value  Das gewandelte ADC Ergebnis
* \return              Die Temperatur in 1 °C
*
*/
int NTC_ADC2Temperature(unsigned int adc_value){

  /* Werte direkt aus der Tabelle lesen. */
  return NTC_table[ adc_value ];
};

Marek128b, 2025-02-04:
https://www.sebulli.com/ntc/index.php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

Marek128b, 2025-02-04:
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

Marek128b, 2025-02-04:
### Fixing problems
1. Vref For Voltage devider

+5V wrong
3V3 OK

Marek128b, 2025-02-09:
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

Closed 2025-02-09.

Thread 91 (2025-02-17):

testing impedance of if filter

Marek128b, 2025-02-17:

Marek128b, 2025-02-17:
### IF impedance transformer

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

Marek128b, 2025-02-17:
### build

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

Marek128b, 2025-02-18:
[Use a NanoVNA to measure input impedance and gain of a small-signal RF amplifier](https://youtu.be/7TtKE39TWpI?si=-CMWBoIUZEeRDa17)

Marek128b, 2025-02-18:
https://k7mem.com/Res_Attenuator.html

Marek128b, 2025-02-18:
Transformer right amount of windings.
https://dl6gl.de/media/files/impedanzanpassung-matching.pdf

Marek128b, 2025-02-19:
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

Marek128b, 2025-02-19:
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

Marek128b, 2025-02-19:
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

Marek128b, 2025-02-19:
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

Marek128b, 2025-02-23:
### Also fixed amplifier Gain

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

Closed 2025-02-23.

Thread 98 (2025-03-03):

Testing Mixer

Marek128b, 2025-03-03:
### What do you want to implement?

I want to test the HF diode ring Mixers.

### Why do you want to implement this?

I need to test if everything works.

Marek128b, 2025-03-03:
### Updated Mixers

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

Marek128b, 2025-03-03:
### changed diodes to BAT54J

[Datasheet for BAT54J](https://assets.nexperia.com/documents/data-sheet/BAT54J.pdf)

| forward Voltage Vf|
|--------|
| 320mV |

Marek128b, 2025-03-05:
### Working DSB-SC with ADE1+

Testing setup:

Audio simulated with 2kHz Function generator with 50mV Peak to Peak Voltage.
Audio connected to ADE1+ IF Port.

Carrier simulated by 16MHz Function generator with output Level of -10dBm, measured as 400mV Peak to Peak.
Carrier on Port RF.

Output from Port LO going to Hack RF One.

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

Marek128b, 2025-03-05:
### Output from Hack RF
No carrier visible unless voltage for carrier increases.
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

Marek128b, 2025-03-06:
### Homebrew Mixer

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

Closed 2025-03-12.

Thread 100 (2025-03-06):

Fixing SI5351 for Mixers

Marek128b, 2025-03-06:
### What do you want to implement?

I want to fix the output Level of the SI5351 not to overpower the Mixers.

### Why do you want to implement this?

I want to implement this feature because i want DSB Modulation.

Marek128b, 2025-03-06:
### Filter on Si5351 port for Audio Mixing BFO
https://www.digikey.at/en/resources/conversion-calculators/conversion-calculator-low-pass-and-high-pass-filter

Of type RC Low Pass.
Frequency set to 1/10 Frequency of BFO to get 20dB attenuation and filtering of Higher frequencies to have a better sin Signal.
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

Marek128b, 2025-03-06:
### Testing with available components.

BFO
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

VFO
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

Marek128b, 2025-03-07:
### not using Filters

Found table for output Level of SI5351.
https://groups.io/g/qrptech/topic/questions_on_using_si5351_and/100276676

| Setting | Scope Vpp |  dBm  |
|---------|-----------|-------|
|  2 mA   |    0.77   |  +7   |
|  4 mA   |    1.35   | +12   |
|  6 mA   |    1.83   | +14   |
|  8 mA   |    2.09   | +15.5 |

Testing with 2mA set in code.

Without Attenuation, Phone as Audio Source at 100/150 Volume.
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

With 20dB Attenuation, Phone at Full 150/150 Volume.
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

Marek128b, 2025-03-07:
### Video of Test
https://youtu.be/WH1OuTjwxkI

Marek128b, 2025-03-08:
### Testing Homebrew Mixer

With LNA Gain set to 24dB in Software.
With **30dB Attenuation**, Phone at Full 150/150 Volume.
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

-50dB Sin. Wave
-85dB Carrier

45dB Carrier suppression.

Marek128b, 2025-03-09:
### Attenuator

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

Closed 2025-03-12.

Thread 106 (2025-03-12):

New Feature: Fixing amplification problem

Marek128b, 2025-03-12:
### What do you want to implement?

I want to fix the Amplification so that you can hear stations.

### Why do you want to implement this?

I want to implement this fix because otherwise you can't hear anything at all.

Marek128b, 2025-03-12:
### Simulated current circuit
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
File > Amplifiers > Phones Amplifier new.asc
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
2nd OP Amp wrong circuit.

Complete rework of right side of Amplifier.
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

Marek128b, 2025-03-12:
### Changes in circuit needed

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

Marek128b, 2025-03-24:
### Fixed and added Heat sink

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

Closed 2025-03-24.

Thread 107 (2025-03-16):

New Feature: Fixing receiver chain

Marek128b, 2025-03-16:
### What do you want to implement?

I want to fix issues in the receiver chain.

### Why do you want to implement this?

I want to fix this because there are some problems with the received signals e.a. weird tones coming through the system etc.

Thread 108 (2025-03-16):

New Feature: Fixing receiver chain.

Marek128b, 2025-03-16:
### What do you want to implement?

I want to fix the receiver.

### Why do you want to implement this?

I want to fix the receiver system. Weird noise Problems.

Marek128b, 2025-03-16:
### Output Audio Spektrum

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

Marek128b, 2025-03-16:
### Input to Second  Mixer after Amp

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

Marek128b, 2025-03-16:
### Firmware VFO BFO calc.

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

Marek128b, 2025-03-17:
### Firmware new calc.

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

Marek128b, 2025-03-25:
### Tested
withC45 in circuit and Sony Ult Wear wired to Audio output.

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
https://helpguide.sony.net/mdr/2981/v1/en/contents/TP1001300235.html

When Headphones are turned off => Impedance is   32 Ohm.
When Headphones are turned on => Impedance is 314 Ohm.

Marek128b, 2025-03-25:
### Fixed issue with audio
BEFORE:
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

AFTER:
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

Marek128b, 2025-03-25:
### Audio Spectrum
| Bevor | After|
|--------|--------|
| 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| 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|

Closed 2025-03-25.

Thread 109 (2025-03-18):

New Feature : adding Seven Segment Display

Marek128b, 2025-03-18:
### What do you want to implement?

I want to implement the circuit to connect my Seven Segment Display

### Why do you want to implement this?

I want to implement this feature because this makes it easier to see the Digits.

Marek128b, 2025-03-18:
### Solder connections

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

Marek128b, 2025-03-18:
### Prepping PCB

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

Marek128b, 2025-03-18:
### Display connection

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

Closed 2025-03-18.
