Marek128b/HAM-Radio-transceiver-DA/doc/case/pdf/Front Plate Drawing v25.pdf

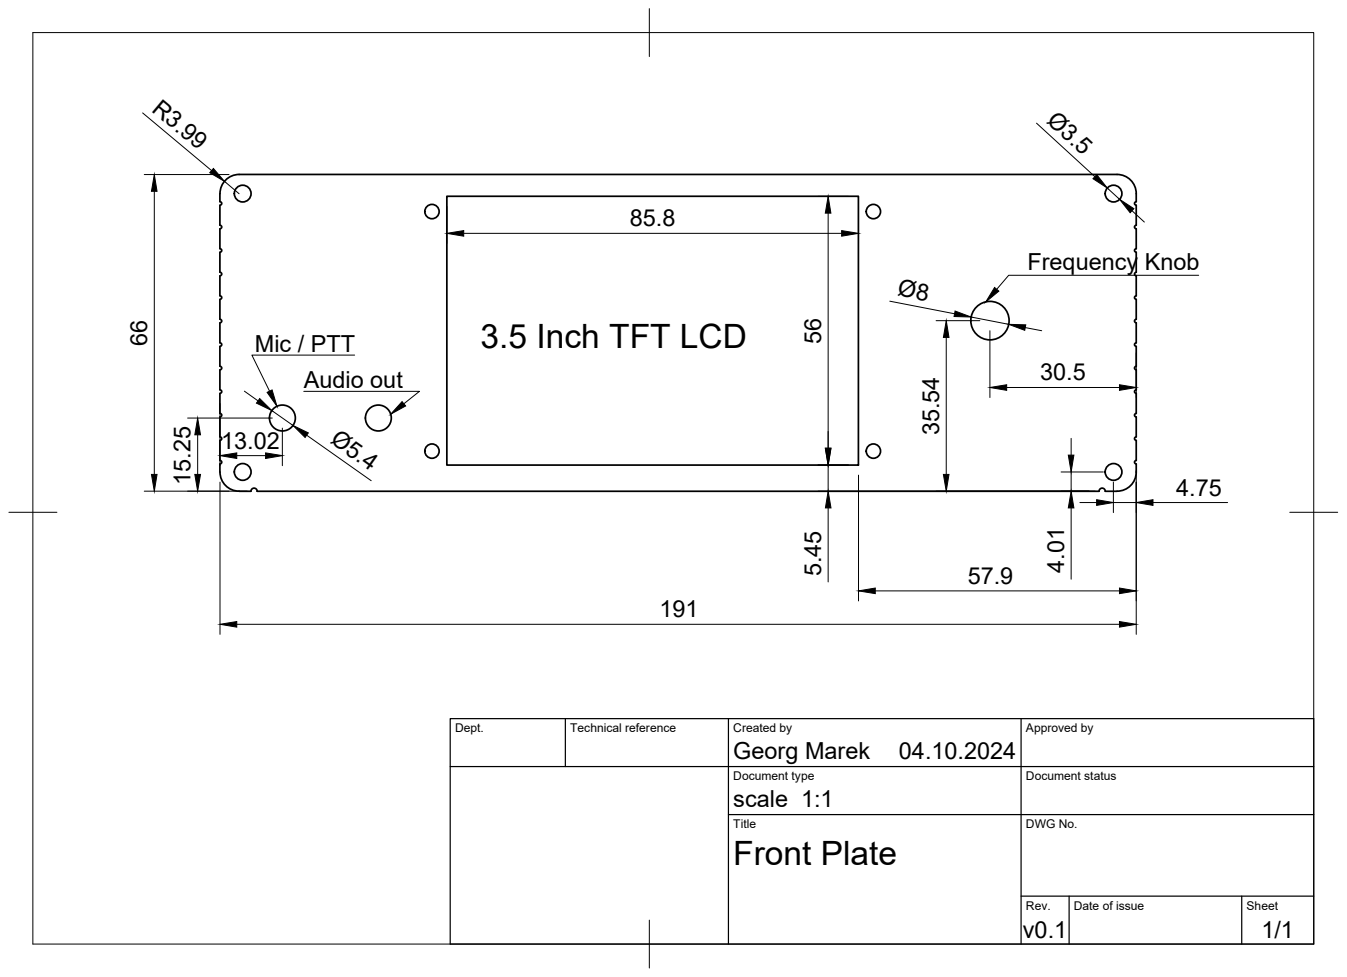
[picture p56: page 1]
Mic / PTT; 3.5 Inch TFT LCD; Frequency Knob; Audio out

Dept. | Technical reference | Created by Georg Marek 04.10.2024 | Approved by

Document type scale 1:1 | Document status

Title Front Plate | DWG No.

Rev. v0.1 | Date of issue | Sheet 1/1
