Marek128b/HAM-Radio-transceiver-DA/Amplifiers/Audio/Headphone amplifier.asc

C1: cap; 10µ
C2: cap; 10µ
Q1: npn; 2N3904
R1: res; 50
R2: res; 2
R3: res; 1k
R4: res; 10k
R5: res; 4
V1: voltage; 12
V2: signal
Named nets: 0
.tran 2m
