Marek128b/HAM-Radio-transceiver-DA/Amplifiers/PA/5W QRP Amplifier from ZL2CTM.asc

C1: cap; 100n
C1: cap; SINE(0 1 14Meg)
L1: ind2; 70µ
L2: ind2; 1µ
L3: ind2; 3.82µ
L4: ind2; 26.53µ
L5: ind2; 3.82µ
L6: ind2; 26.53µ
Q2: npn; 2SCR375P
R2: res; 200
R3: res; 150
R4: res; 50
R5: res; 50
V1: signal; SINE(0 3 14Meg); Rser=50
V2: voltage; 12
V3: signal; SINE(0 24 14Meg); Rser=7.2
Named nets: 0, vout, vin
k2 l3 l4 1
.tran 0 2u 1u
k3 l5 l6 1
.step param res list 10 15 20 30 50
.step param res list
k1 l1 l2 1
