Marek128b/HAM-Radio-transceiver-DA/Amplifiers/PA/10W QRP Amplifier class B.asc

C1: cap; 10µ
L1: ind2; 10µ
L2: ind2; 10µ
L3: ind2; 10µ
L4: ind2; 30µ
L5: ind2; 30µ
L6: ind2; 80µ
L7: ind2; 15µ
L8: ind2; 15µ
L9: ind2; 80µ
Q1: npn; 2N2222
Q2: npn; 2N2222
R3: res; 120
R4: res; 820
RL1: res; 50
RL: res; 50
V1: signal; SINE(0 2 15Meg); Rser=50
V2: voltage; 12
V3: voltage; 12
V4: signal; SINE(0 12 15Meg); Rser=7.2
V5: signal; SINE(0 12 15Meg 0 0 180); Rser=7.2
Named nets: 0, uout, uout1
k1 l1 l2 l3 1
k2 l6 l4 l5 1
.tran 0 2u 1u
.step param res list 120
k3 l7 l8 l9 1
