Marek128b/HAM-Radio-transceiver-DA/Amplifiers/PA/0.5W QRP Amplifier class B from Video.asc

C1: cap; 470n
C2: cap; 470n
L1: ind2; 1.6m
L2: ind2; 1.6m
L4: ind2; 4.09m
L5: ind2; 4.09m
L6: ind2; 800µ
Q1: npn; 2N3904
Q2: npn; 2N3904
R1: res; 22
R2: res; 22
R3: res; 220
R4: res; 6.8k
R5: res; 25
R6: res; 25
R7: res; 6.8k
R9: res; 220
RL: res; 50
V1: signal; SINE(0 10 15Meg); Rser=50
V2: voltage; 20
Named nets: 0, vout
k2 l6 l4 l5 1
.tran 0 10u 2u
.step param res list 5 7 10 12 15
k1 l1 l2 1
