Marek128b/HAM-Radio-transceiver-DA/Amplifiers/PA/10W QRP Amplifier class A.asc

C1: cap; 10n
C2: cap; 10n
D1: diode; 1N4007
D2: diode; 1N4007
L1: ind2; 8µ
L2: ind2; 15µ
Q1: npn; BC547B
Q2: pnp; BC557B
R1: res; 50
R2: res; 1k
R3: res; 1k
V1: voltage; 12
V2: signal; SINE(0 5 15Meg); Rser=50
Named nets: 0, +12V
k1 l1 l2 1
.tran 1u
