Marek128b/HAM-Radio-transceiver-DA/Amplifiers/PA/5W QRP Amplifier.asc

L1: ind; 56µ
L2: ind; 10µ
L3: ind2; 400µ
L4: ind2; 100µ
M1: nmos; IRFZ44N
R1: res; 50
V1: voltage; 12
V2: signal; SINE(0 4 30Meg); Rser=50
V3: voltage; 0
Named nets: 0
P: 5W
RL: 16.62 Ohm
L1: 52.89 uH
.tran 100n
k1 l3 l4 1
