Marek128b/HAM-Radio-transceiver-DA/Amplifiers/PA/Draft2.asc

C1: cap; 680µ
C2: cap; 680µ
C3: cap; 0.1µ
D1: diode; 1N4007
L1: ind2; 40m
L2: ind2; 10m
L3: ind; 10µ
L4: ind; 10µ
L5: ind2; 5m
L6: ind2; 5m
L7: ind; 10µ
L8: ind2; 40m
Q1: npn
Q2: npn
R1: res; 10
R2: res; 10
R3: res; 33
R4: res; 33
R5: res; 130
R6: res; 82
R7: res; 50
V1: signal; SINE(0 1 1Meg 1u); Rser=20
V2: voltage; 12
Named nets: 0
k1 l1 l2 1
k2 l8 l5 l6 1
