Marek128b/HAM-Radio-transceiver-DA/Amplifiers/PA/Draft3.asc

L1: ind2; 100µ
L2: ind2; 400µ
R1: res; 50
R2: res; 200
V1: signal; SINE(0 1 1Meg); Rser=50
V2: signal; SINE(0 1 1Meg); Rser=50
Named nets: 0
.tran 10u
turnratio 1:2
inductanceratio 1:4
Z ratio 1:4
k1 l1 l2 1
