Marek128b/HAM-Radio-transceiver-DA/filters/20m BP Filter/new/filter (1).asc

C1: cap; 1.5n
C2: cap; 15p
C3: cap; 1.5n
L1: ind; 56.00n
L2: ind; 6.800µ
L3: ind; 56.00n
RL: res; 50
V1: voltage; ""; AC 1 0; Rser=50.00
Named nets: 0
.ac dec 1001 8.535Meg 21.86Meg
.net I(RL) V1
3rd Order Chebyshev Bandpass
Conventional, Shunt First
Lower Cutoff Freq. = 13 MHz; Upper Cutoff Freq. = 14.35 MHz
Passband Ripple = 0.10 dB

rf-tools.com | Feb 10 2025 18:34
