Marek128b/HAM-Radio-transceiver-DA/(list of files, drawings)

Other design files:
Amplifiers/Audio Output/audio output amplifier.ms14
Amplifiers/PA/Power Amplifier.ms14
Amplifiers/simulations/Microphone amplifier variable gain with LM358.ms14
doc/schematics-and-layouts/microcontroller HAM radio 20m QRP.fzz
