Marek128b/HAM-Radio-transceiver-DA/(commit log)

2024-05-09 added receiver drawing, band pass filters pdf and mixer example #1
2024-06-11 added tests for neoPixel, SD card in SPI mode, SI5351, encoder with interrupt
2024-06-19 added basic drawing for breadboard in fritzing
    [microcontroller HAM radio 20m QRP.fzz]
2024-06-23 added multisim microphone amplifier simulation
    [Microphone amplifier variable gain with LM358.ms14]
2024-06-25 added fritzing controller drawing
    [microcontroller HAM radio 20m QRP.fzz]
2024-06-25 added working and tested LM358 Multisim
    [Microphone amplifier variable gain with LM358.ms14]
2024-07-03 changed example to display milliseconds every 10ms
2024-07-03 added LM358 simulation in MS
    [Microphone amplifier variable gain with LM358.ms14]
2024-07-05 note: Display works with ESP32 version 5.3.0 and not newest. added custom fonts to millis example
2024-07-19 added readme and images to if filter
2024-07-19 added images and changed readme in IF filters
2024-07-28 added text to README.md if IF filters
2024-07-28 added 20m BP docs
    [Air Coil 12x11mm.3mf, Air Coil 5x4mm.3mf]
2024-09-14 changed pin definitions for new esp32-c3 module, not tested
2024-09-17 added calibration code for Si5351
2024-09-17 added calibration value
2024-09-17 changed fritzing drawing
    [microcontroller HAM radio 20m QRP.fzz]
2024-09-27 added LTspice 5W PA simulation working
    [Power Amplifier.ms14]
2024-10-04 added front plate, changed system structure
    [Front plate.3mf]
2024-10-05 added new front plate design and case image
    [Front plate v0.1 .3mf, Front plate.3mf]
2024-10-22 added firmware v0.0.1; corrected BFO and drive strength
    [main.cpp]
2024-10-22 added working calibrated si5351 code, note: don't update frequency in a loop
2024-10-23 Bluetooth Connection 0.5 Addresse und teiles des Designs hinzugefügt
2024-10-23 added images and mermaid to receiver
    [audio output amplifier.ms14]
2024-11-05 Bluetooth Connection 0.6 1. Design Konzept implementiert und Button verbessert
2024-11-05 Bluetooth Connection 0.7 Scanned Devices working :)
2024-11-05 added bluetooth test for esp32
2024-12-16 added oneWireDisplay to pin 48 in v0.0.4, not tested
2024-12-17 added rx tx switch
2025-01-11 added v0.0.5 firmware rxtx switch and vbat measurements
2025-01-14 added v0.0.6 Firmware, added voltage measurement to display and fixed rxtx state to display
    [main.cpp]
2025-01-21 fixed sending issue and added random voltage test measurements
    [main.cpp]
2025-02-04 added working NTC temperature read with LUT
2025-02-09 added temperature sensing to main code
2025-02-10 added 20m BP filter better simulation files
2025-02-18 fixed Serial, added temperature random
    [main.cpp]
2025-02-22 fixed response time issue, now max. 50ms instead of 1.5s
    [main.cpp]
2025-03-04 added partial display update sprites, updated to faster SPI clock. New Feature making display faster #99
2025-03-07 added output level control and Voltage chart, firmware v0.0.9 #100
2025-03-08 added new encoder lib, v0.1.0
2025-03-10 added error handling to bt
    [main.cpp]
2025-03-12 added 20m Filter simulation
2025-03-17 added debounce for encoder switch, v0.1.2
2025-03-22 updated firmware to fix encoder switch v0.1.3
    [main.cpp]
2025-04-03 updated fritzing circuit diagram
    [microcontroller HAM radio 20m QRP.fzz]
